sappystick/ARX/docs/figures/SIM_THERMAL.png

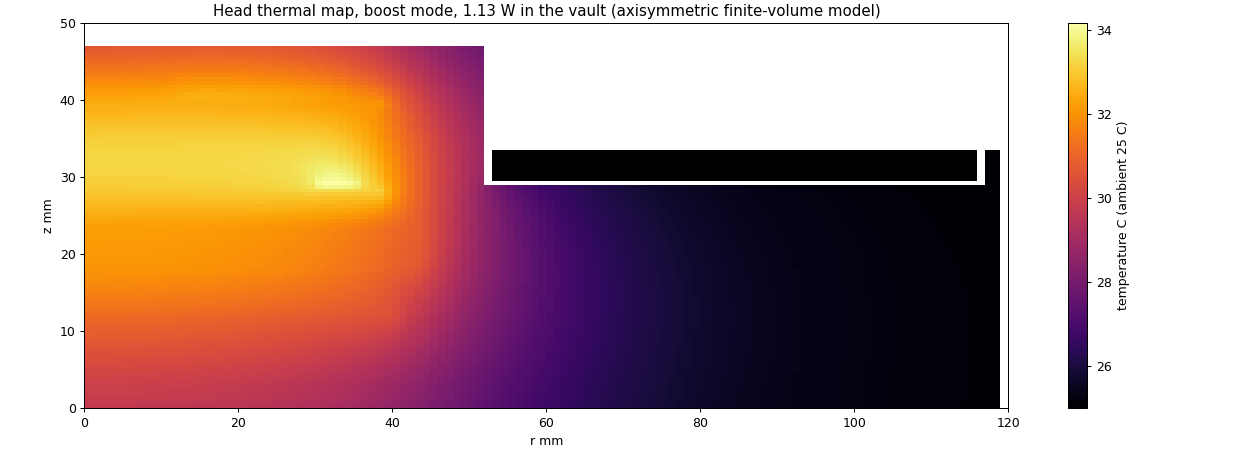
docs/figures/SIM_THERMAL.png
