sappystick/ARX/prompts/cowork/C04_DESIGN_REVIEW_DECK.md

# C04 Design review deck
Use the pptx skill. Build Outputs/DESIGN_REVIEW.pptx (12 slides max) from docs/figures (LEVELS_PLAN_VIEWS, LEVELS_SCHEMATIC, RX_PLATFORM_QUAD, SIM_*, cut-aways) and docs/DESIGN_STATE.md: architecture, coil, vault levels, receiver platform and what the simulation showed (leak 300-1000x lower, first gate 6.3 us), TX stage, thermal, shaft/yoke, corrections log, open items and risks. One decision per slide; every number labelled modeled; last slide: what we need to measure first.
