sappystick/ARX/prompts/P02_CB1D_ROUTING_DRC.md

# P02 Finish CB1D routing and add an independent DRC
STATUS (2026-10-23): done in release 5.1: 46/46 nets, independent DRC 0/0, notch half-width 7.6 mm (not 12 mm). Remaining: KiCad/CAM verification (docs/OPEN_ITEMS.md 2).
Goal: 46/46 nets on CB1D (45/46 now), hatched planes, 12 mm notch at 90 deg, Gerbers, and an INDEPENDENT design-rule check.
Context: src/pcb/pw_design.py (PW=C DISC=1), cb1d_export.py, router.py, route_run.py, gerber_out.py (hatch and notch options exist). The 64-part board has HV nets (coil flyback, damping chain, 630 V coupling cap); data/legacy/.../PF233-CB1D.kicad_dru has the intended rules.
Steps: (1) run `make route-cb1d`, read the failing net, try layer-assignment and ordering changes in router.py (rip-up and reroute, via cost, escape strategy); (2) if still blocked, propose the smallest placement change (move a part, rotate a connector) and re-run placement checks; (3) write tests/drc.py that reads the .net, pads and the route JSON and checks connectivity (every net one component), shorts between nets, minimum clearance by net class (HV >= 1.0 mm), annular ring, drill, notch keep-out, edge clearance; (4) export Gerbers with hatched planes; (5) if KiCad (kicad-cli) is available, import the Gerbers and the .kicad_pcb and run its DRC as a second opinion; (6) update docs and regress.
Acceptance: 46/46 nets, drc.py clean, no solid planes, HV clearance reported. If something cannot be done, say exactly what and why.
