sappystick/ARX/docs/PROCESS.md

# Engineering loop and claims policy
## The loop (every change)
1. State the requirement and the failure it fixes (one sentence, measurable).
2. Change the PARAMETRIC GENERATOR, never an STL by hand.
3. Verify geometry: closed mesh, interface clearances measured from the meshes, fit of real parts (boards, tiles, tubes), print constraints.
4. Verify electronics: ERC/placement/routing/DRC, connector pin-by-pin against neighbouring boards, ratings versus simulated stress.
5. Simulate with stated assumptions; run a sensitivity or convergence check; compare to an analytic limit when one exists.
6. Red-team: ask what would make the result wrong; look for the opposite sign, units, and a frame mix-up.
7. Update docs/DESIGN_STATE.md, CORRECTIONS.md if something earlier was wrong, ASSUMPTIONS.md, OPEN_ITEMS.md, and the regression numbers in tests/regress.py.
8. Package: new versioned files, manifest with hashes, superseded notes.
## Claims policy
- "Modeled" means a simulation with listed assumptions; "built" means printed/wound; "measured" means a bench measurement. Never use a stronger word than the evidence.
- A performance claim needs: the model, the assumptions, the sensitivity, and what measurement would confirm it. "Record" claims are not allowed without comparative measurements.
- If a simulation contradicts an earlier statement, add a row to CORRECTIONS.md and say so plainly in the report.
## Validation ladder
analytic check -> mesh/geometry check -> circuit/field simulation -> independent re-derivation (another method) -> bench test -> field test. Most items here sit at rungs 1-3.
## Definition of done for a part or board
Generator committed; checks pass in tests/regress.py; assumptions listed; superseded files marked; STL/Gerber manifest updated; a figure exists that a reviewer can read in one minute.
