sappystick/ARX/prompts/P09_REGRESSION_RELEASE.md

# P09 Regression and release
Run `make verify-full` and tests/regress.py, extend the regression with every number in docs/DESIGN_STATE.md that can be recomputed, refresh stl/MANIFEST.csv hashes, update docs, commit, and write a release note: what changed, which numbers moved, what is still unproven. Do not push.
