sappystick/ARX/prompts/P10_GITHUB.md

# P10 Publish
Run scripts/push_to_github.sh yourself (it needs your credentials; Claude must not handle tokens). It initialises git, enables Git LFS for STL files and pushes to https://github.com/Sappystick/Arx.git (pass another URL as the first argument). Check that work/ is not committed and that large formers are not in git.
