sappystick/ARX/docs/figures/HEAD_CUTAWAY_B_SPINE.png

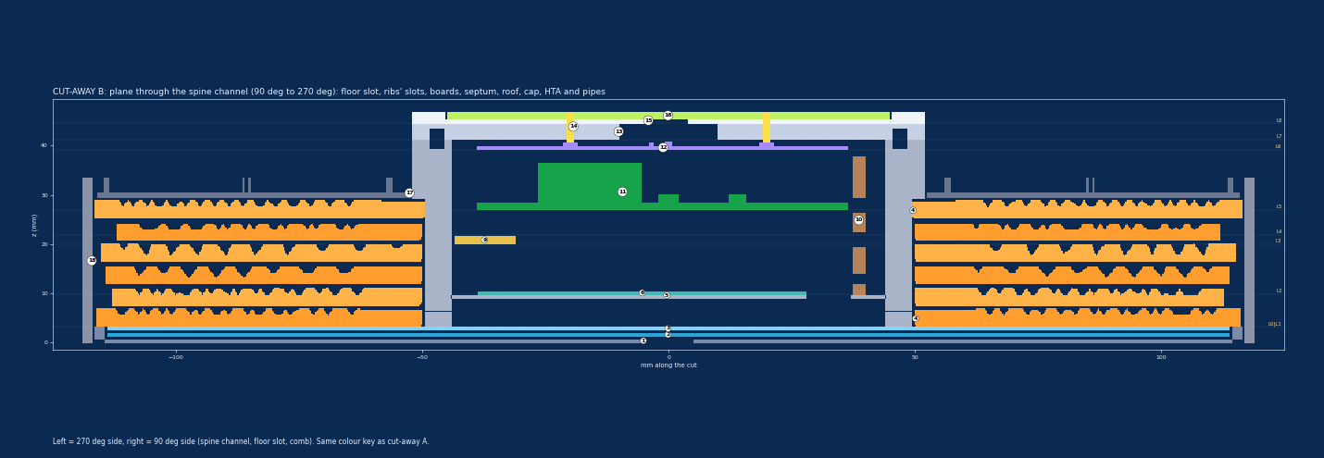
docs/figures/HEAD_CUTAWAY_B_SPINE.png
