sappystick/ARX/docs/figures/HEAD_EXPLODED_LAYERS.png

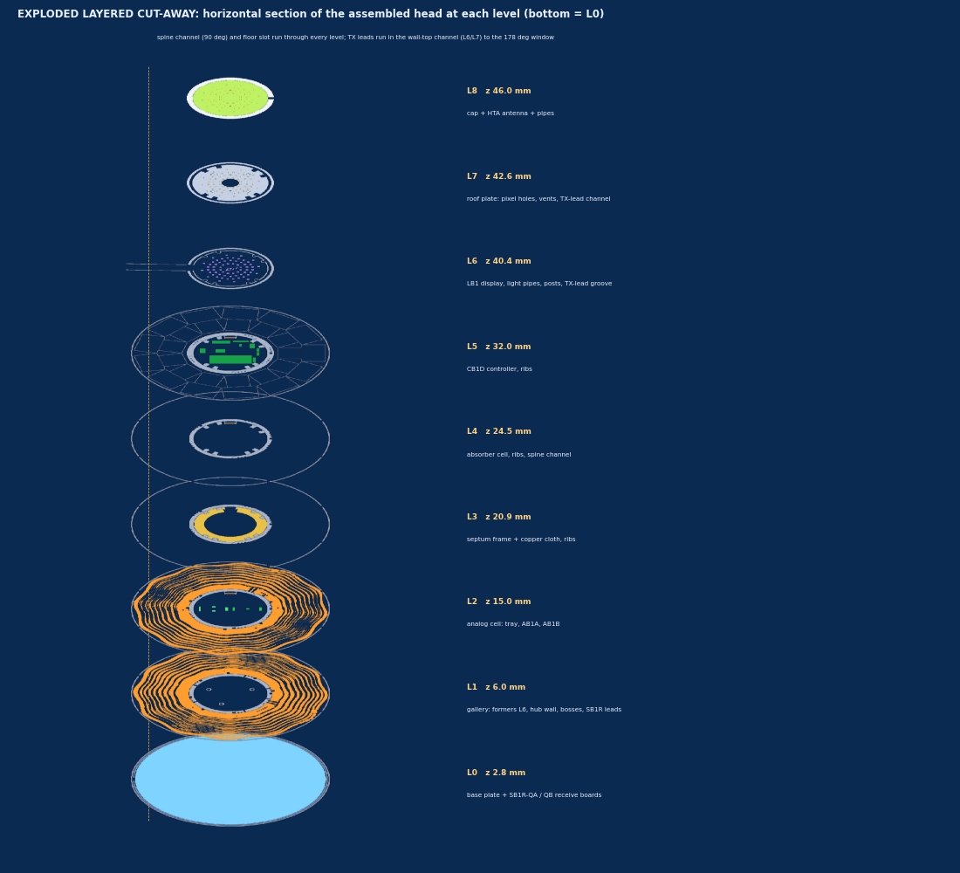
docs/figures/HEAD_EXPLODED_LAYERS.png
