sappystick/ARX/docs/figures/HEAD_LAYERS_EXPLODED.png

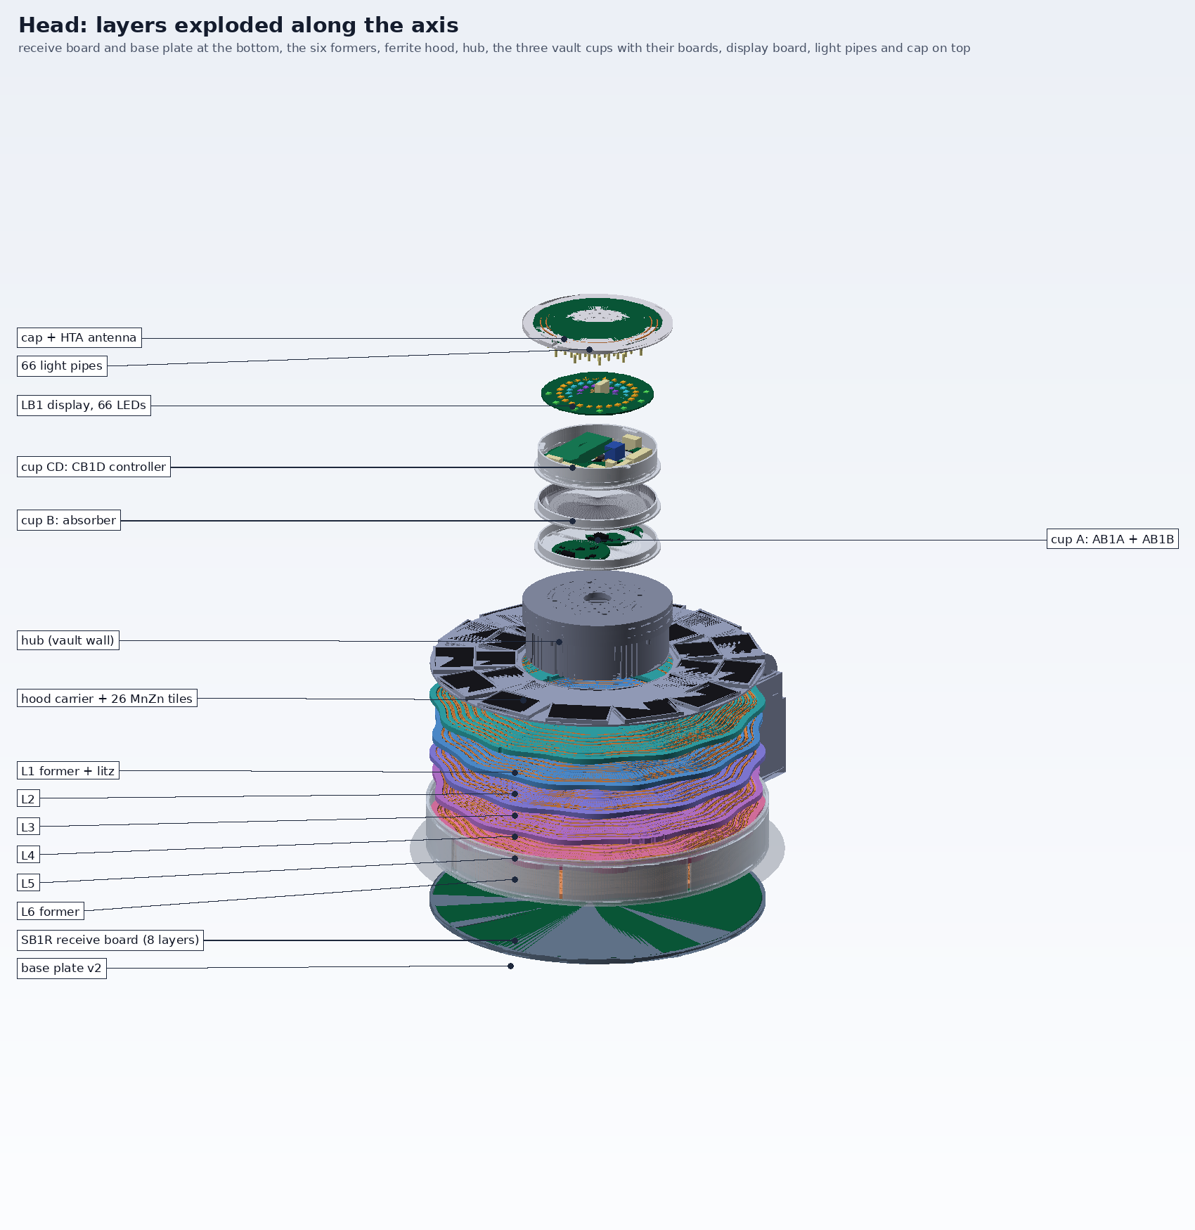
docs/figures/HEAD_LAYERS_EXPLODED.png
