sappystick/ARX/docs/figures/HOOD_V3_LAYOUT.png

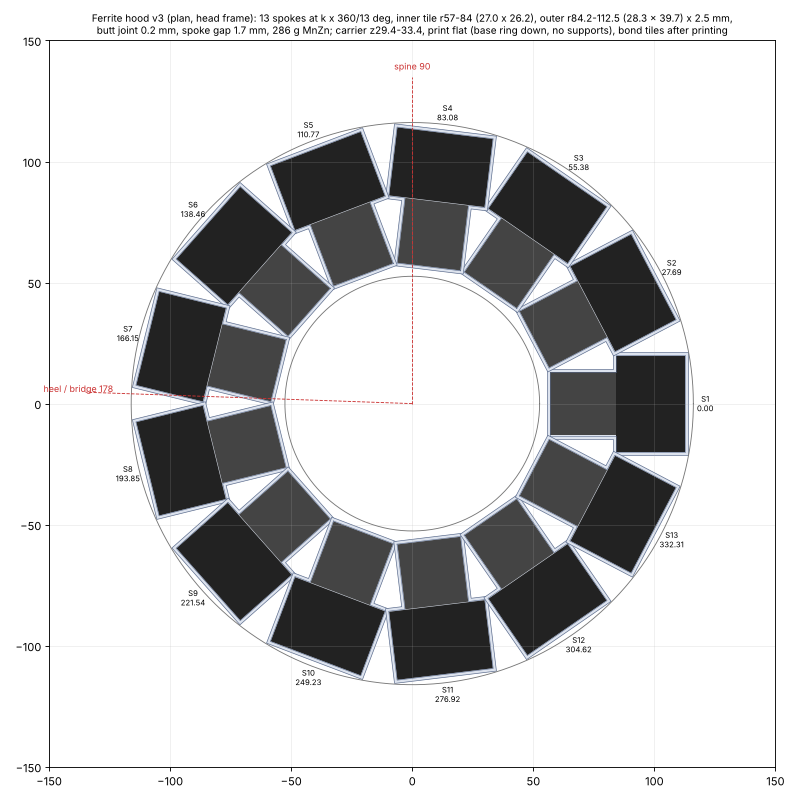
docs/figures/HOOD_V3_LAYOUT.png
