sappystick/ARX/docs/figures/LEVELS_PLAN_VIEWS.png

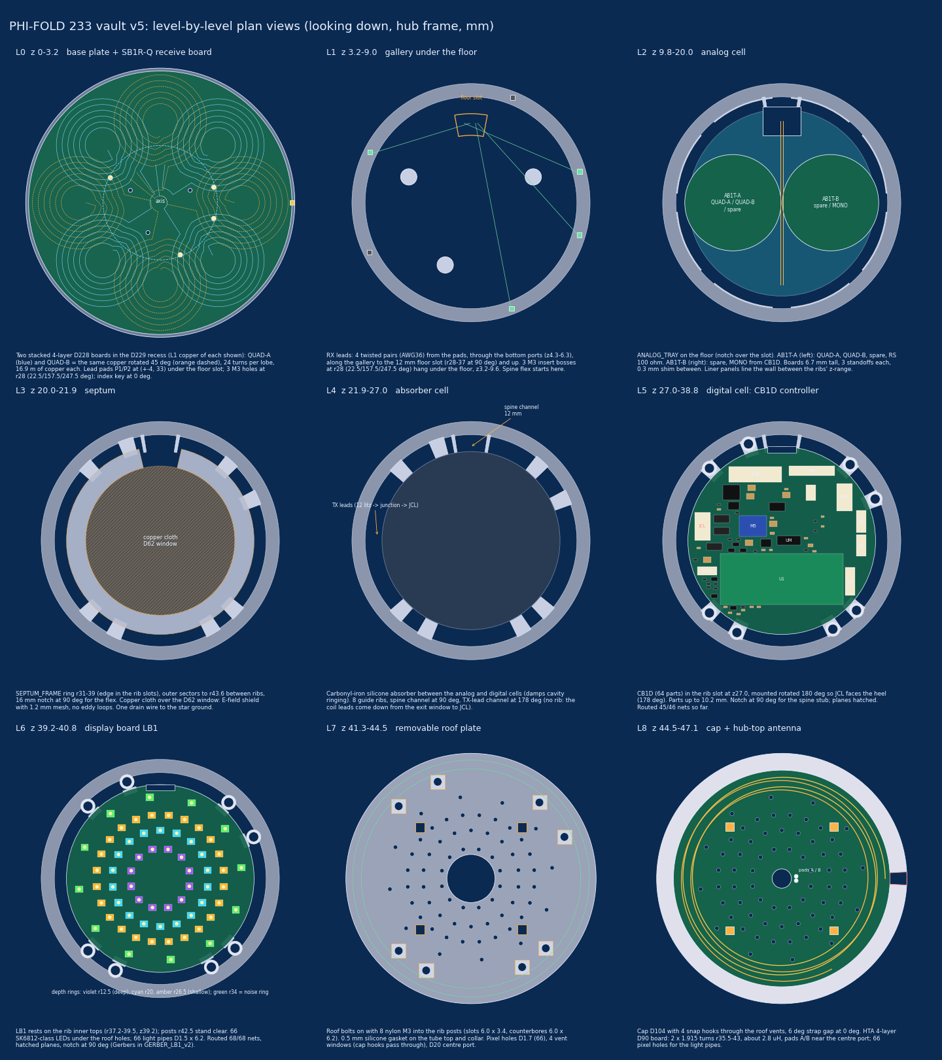
docs/figures/LEVELS_PLAN_VIEWS.png
