sappystick/ARX/docs/figures/LEVELS_SCHEMATIC.png

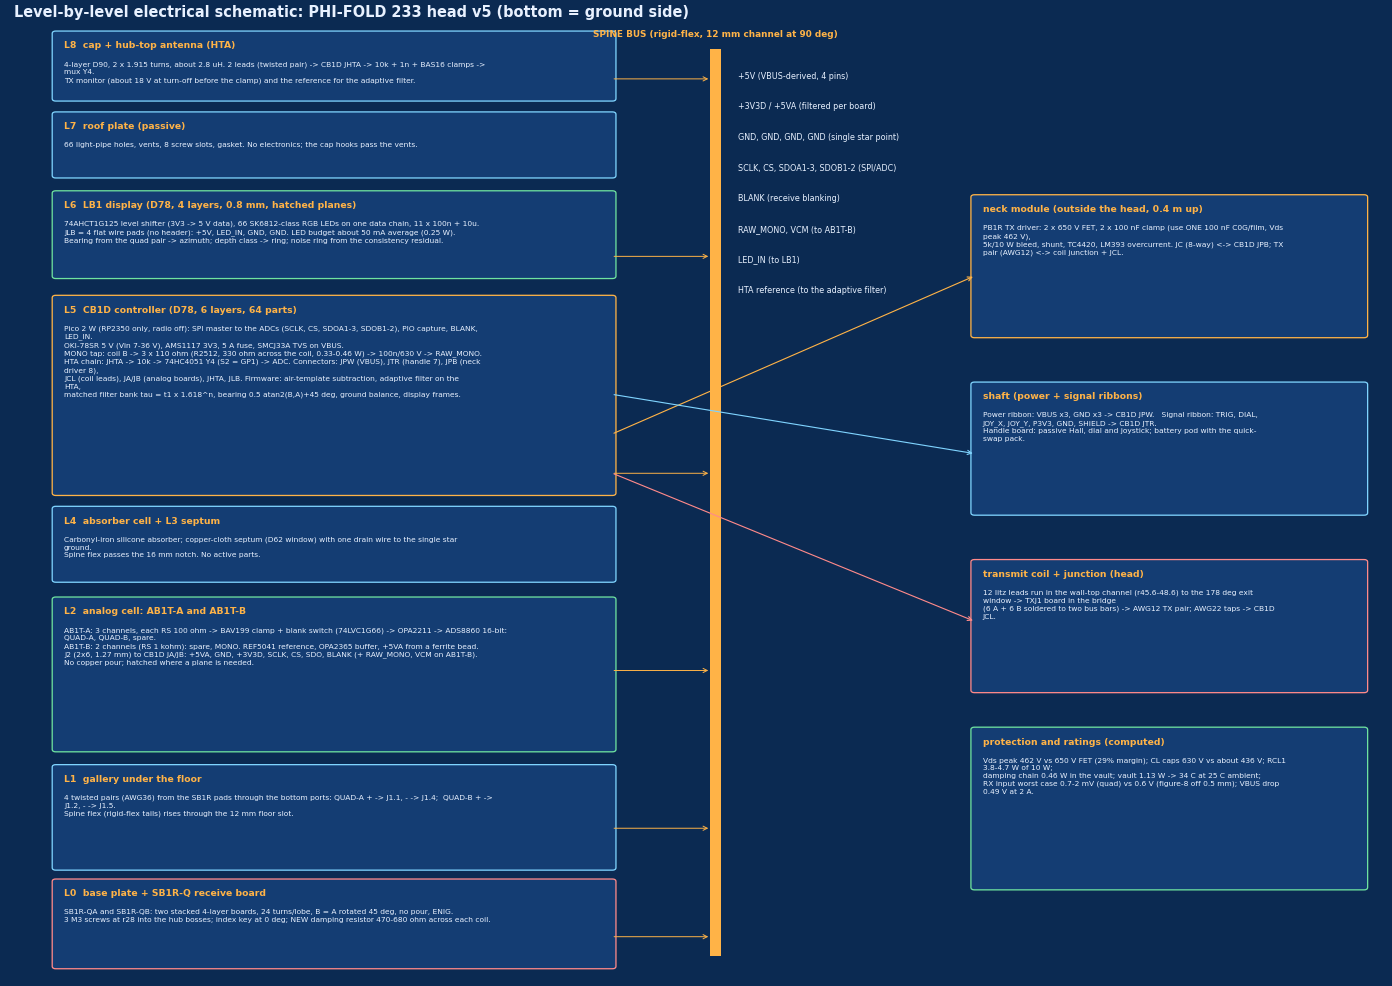
docs/figures/LEVELS_SCHEMATIC.png
