sappystick/ARX/docs/figures/PF233-CB1D_placement_preview.png

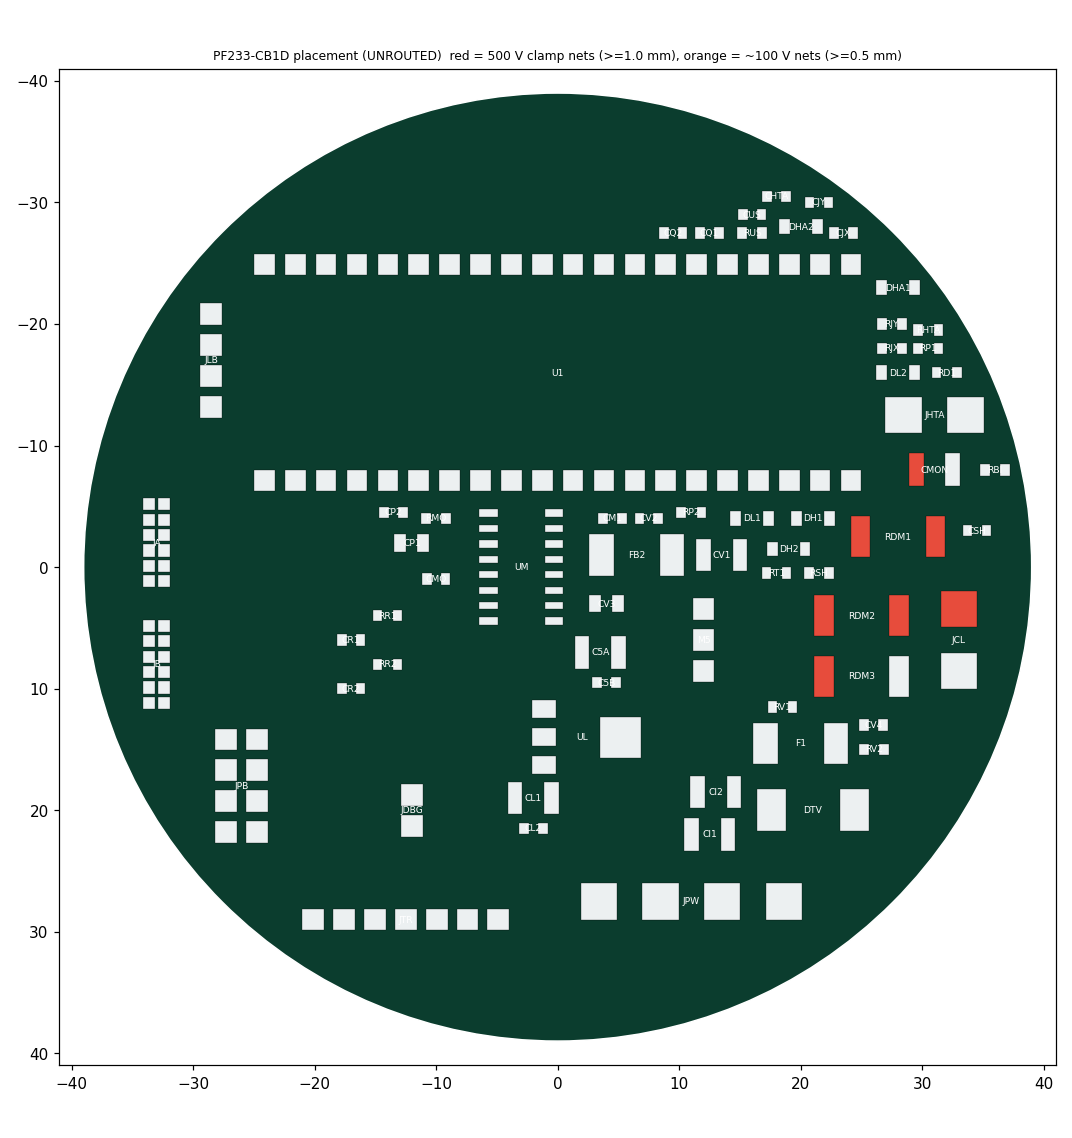
docs/figures/PF233-CB1D_placement_preview.png
