sappystick/ARX/docs/figures/PF233-HTA_preview.png

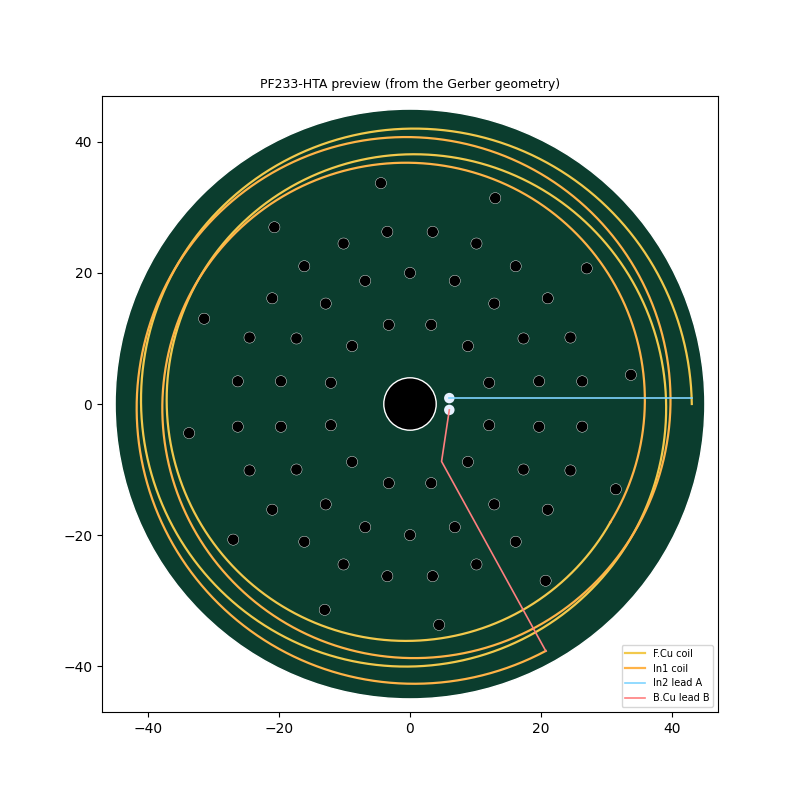
docs/figures/PF233-HTA_preview.png
