sappystick/ARX/docs/figures/RX_PLATFORM_QUAD.png

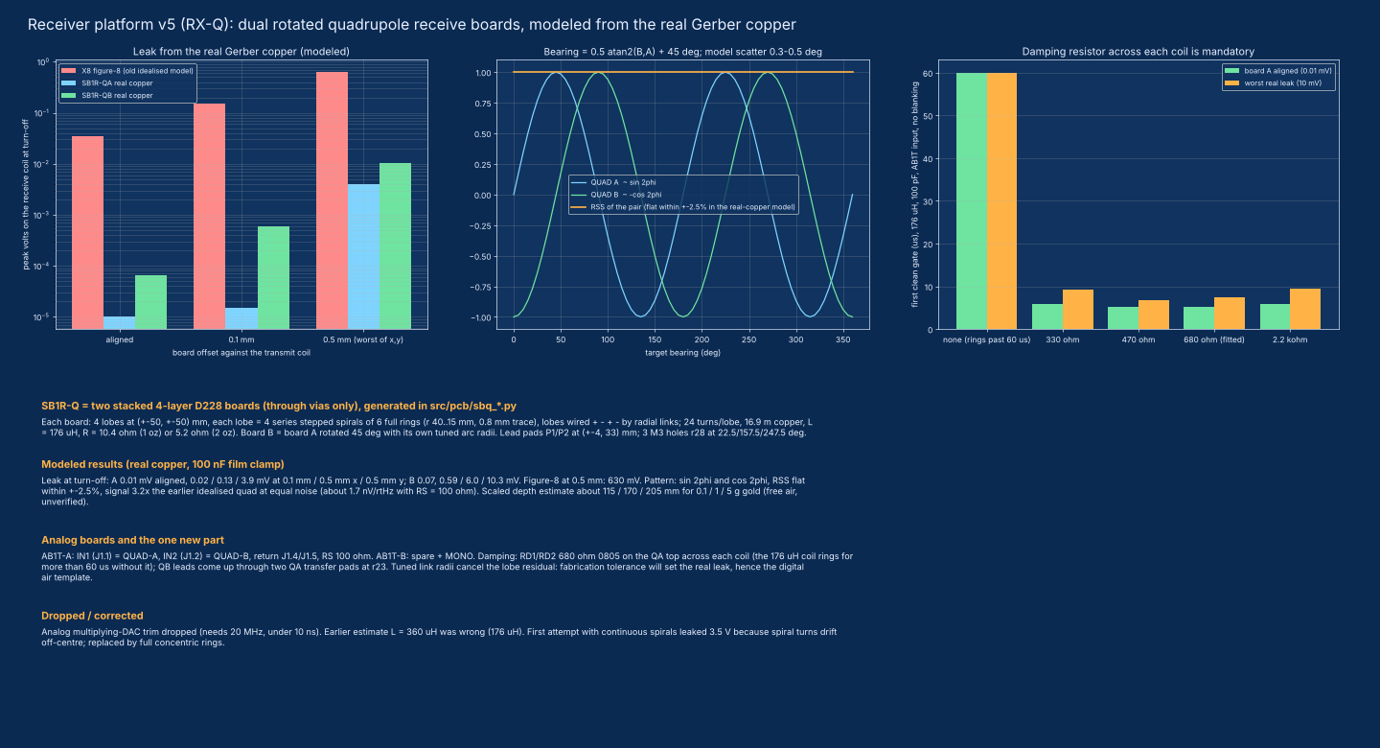
docs/figures/RX_PLATFORM_QUAD.png
