sappystick/ARX/docs/figures/SYSTEM_FOLDED.png

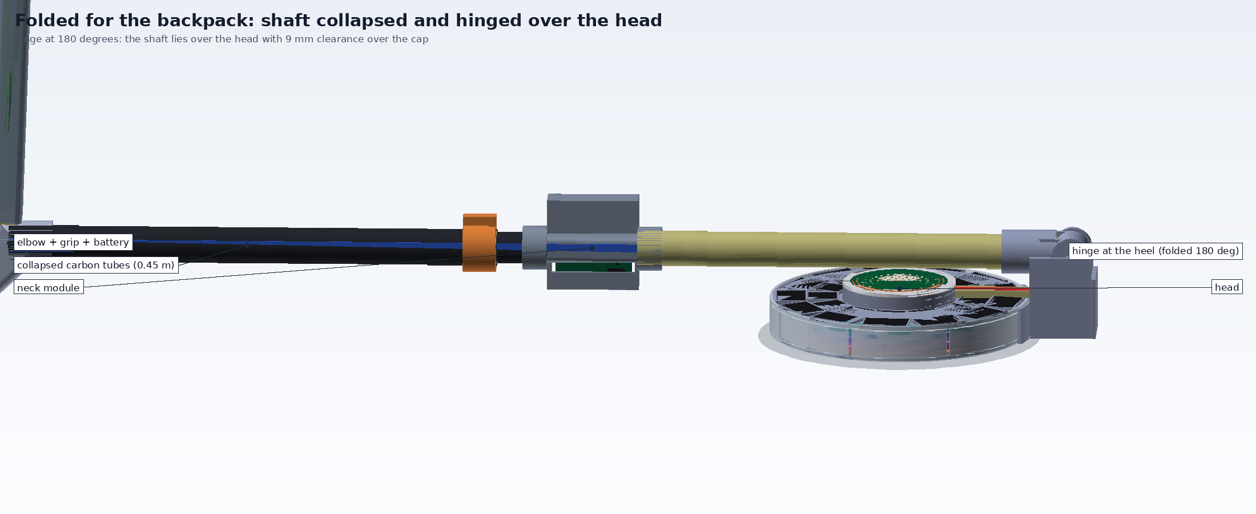
docs/figures/SYSTEM_FOLDED.png
