sappystick/ARX/docs/figures/SYSTEM_SCHEMATIC_v1.png

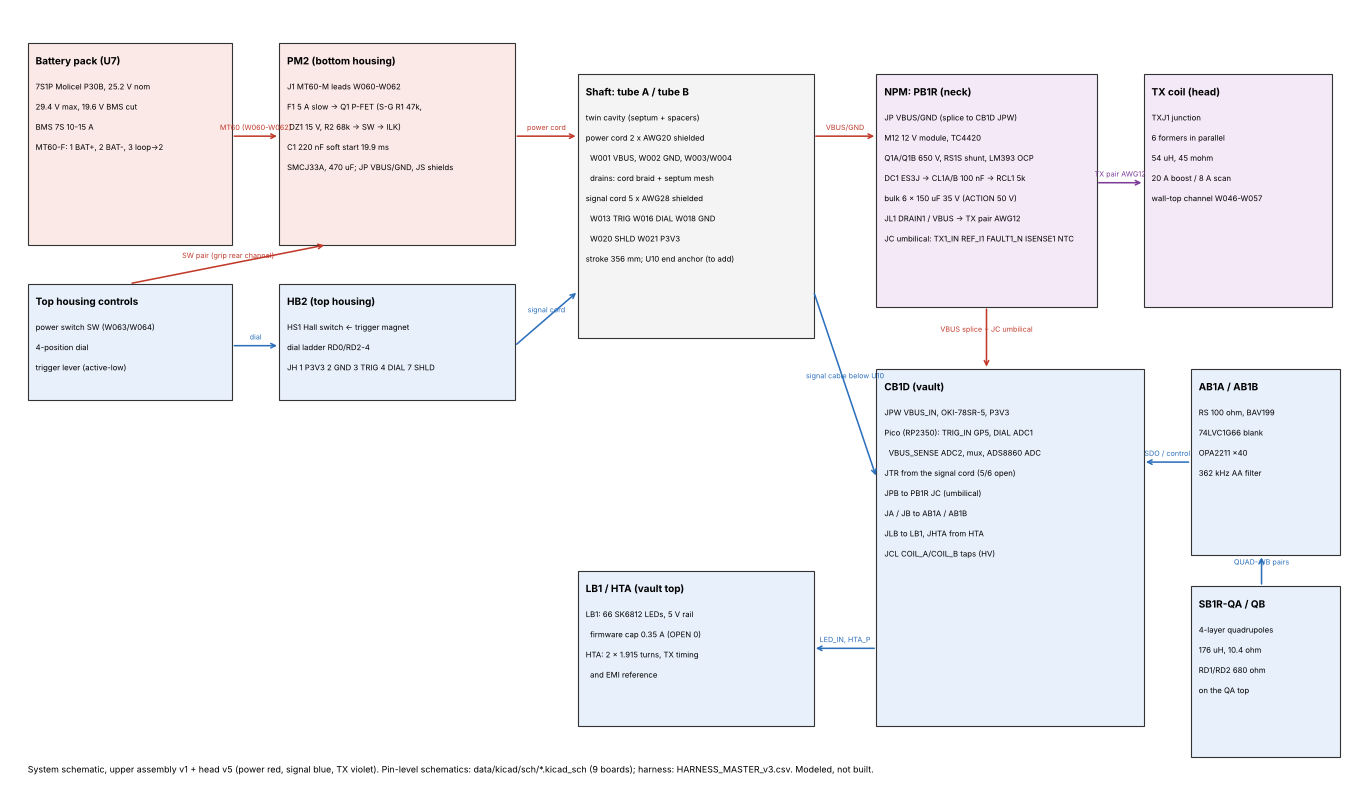
docs/figures/SYSTEM_SCHEMATIC_v1.png
