sappystick/ARX/docs/figures/TARGET_FIELD_LAYERS_3D.png

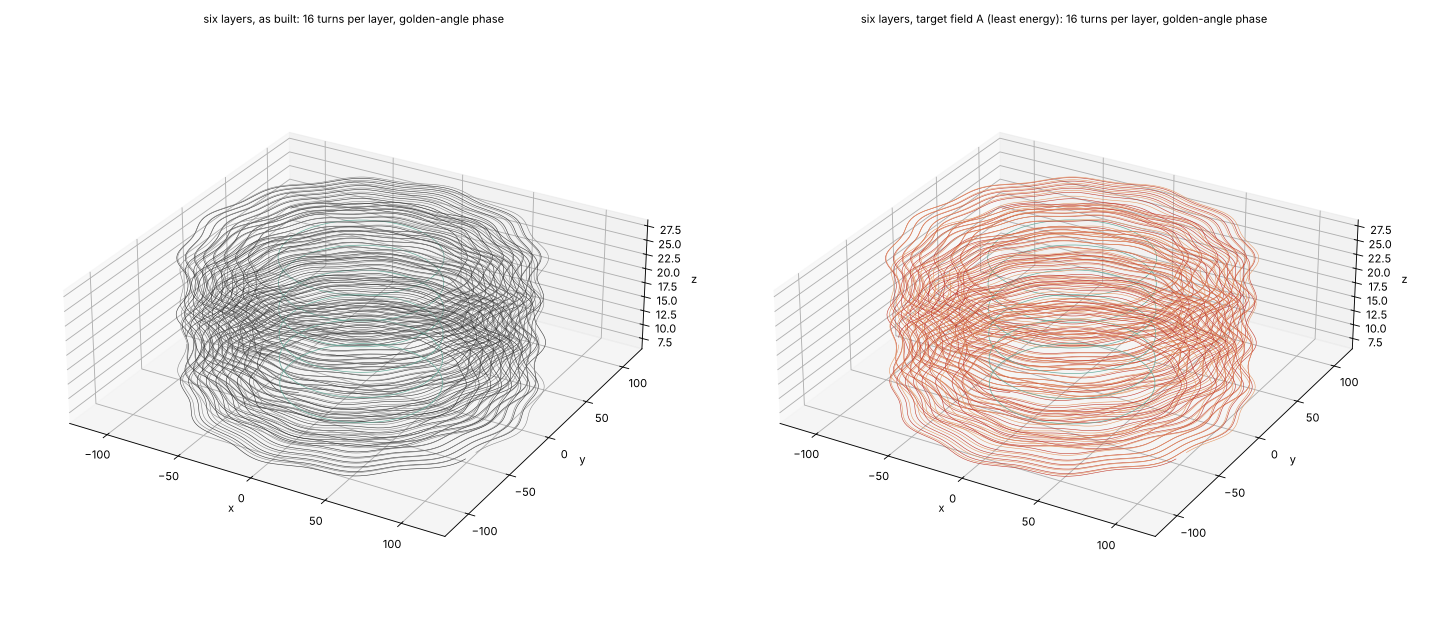
docs/figures/TARGET_FIELD_LAYERS_3D.png
