sappystick/ARX/docs/figures/VAULT2_AND_TANR_DIAGRAM.png

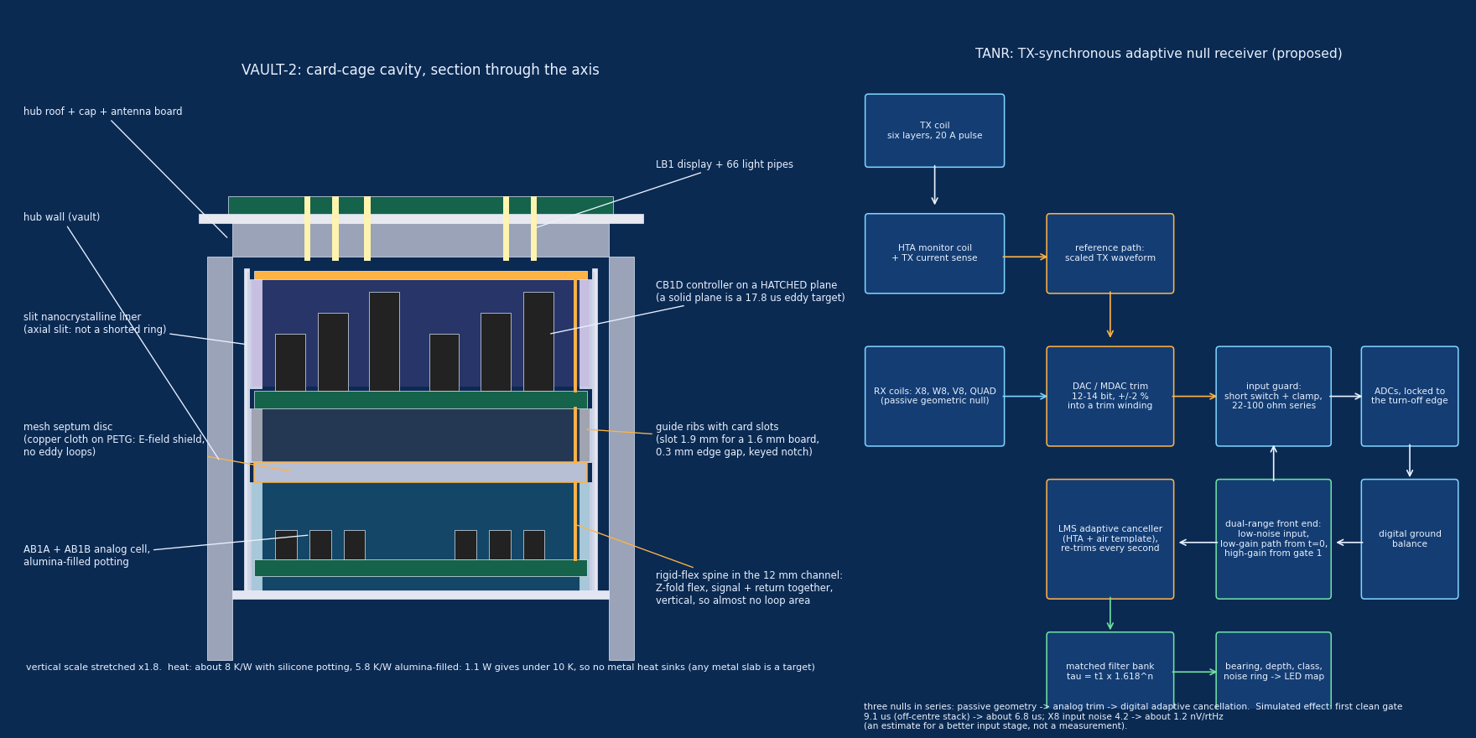
docs/figures/VAULT2_AND_TANR_DIAGRAM.png
