sappystick/ARX/docs/reference/photos/IMG_2941.jpeg

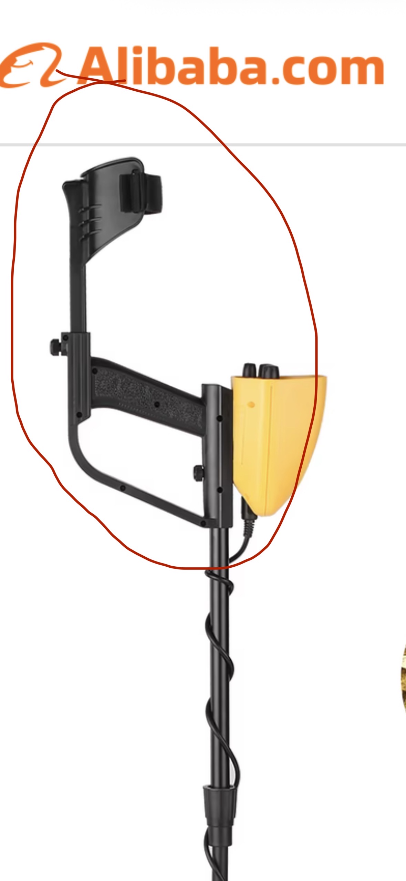
docs/reference/photos/IMG_2941.jpeg
