sappystick/ARX/data/results/LEVEL_NETLIST_FROM_NETLISTS.csv

level | from | pin | net | to | pin | net | status
L2 | CB1D.JA | 1 | +5VA | AB1A.J2 | 1 | +5VA | OK
L2 | CB1D.JA | 2 | GND | AB1A.J2 | 2 | GND | OK
L2 | CB1D.JA | 3 | +3V3D | AB1A.J2 | 3 | +3V3D | OK
L2 | CB1D.JA | 4 | GND | AB1A.J2 | 4 | GND | OK
L2 | CB1D.JA | 5 | SCLK | AB1A.J2 | 5 | SCLK | OK
L2 | CB1D.JA | 6 | CS | AB1A.J2 | 6 | CS | OK
L2 | CB1D.JA | 7 | SDOA1 | AB1A.J2 | 7 | SDO1 | OK
L2 | CB1D.JA | 8 | SDOA2 | AB1A.J2 | 8 | SDO2 | OK
L2 | CB1D.JA | 9 | SDOA3 | AB1A.J2 | 9 | SDO3 | OK
L2 | CB1D.JA | 10 | BLANK | AB1A.J2 | 10 | BLANK | OK
L2 | CB1D.JA | 11 | GND | AB1A.J2 | 11 | GND | OK
L2 | CB1D.JA | 12 | GND | AB1A.J2 | 12 | GND | OK
L2 | CB1D.JB | 1 | +5VA | AB1B.J2 | 1 | +5VA | OK
L2 | CB1D.JB | 2 | GND | AB1B.J2 | 2 | GND | OK
L2 | CB1D.JB | 3 | +3V3D | AB1B.J2 | 3 | +3V3D | OK
L2 | CB1D.JB | 4 | GND | AB1B.J2 | 4 | GND | OK
L2 | CB1D.JB | 5 | SCLK | AB1B.J2 | 5 | SCLK | OK
L2 | CB1D.JB | 6 | CS | AB1B.J2 | 6 | CS | OK
L2 | CB1D.JB | 7 | SDOB1 | AB1B.J2 | 7 | SDO1 | OK
L2 | CB1D.JB | 8 | SDOB2 | AB1B.J2 | 8 | SDO2 | OK
L2 | CB1D.JB | 9 | BLANK | AB1B.J2 | 9 | BLANK | OK
L2 | CB1D.JB | 10 | MONO_IN | AB1B.J2 | 10 | RAW_MONO | OK
L2 | CB1D.JB | 11 | VCM_OUT | AB1B.J2 | 11 | VCM | OK
L2 | CB1D.JB | 12 | GND | AB1B.J2 | 12 | GND | OK
L6 | CB1D.JLB | 1 | +5V | LB1.JLB | 1 | +5V | OK
L6 | CB1D.JLB | 2 | LED_IN | LB1.JLB | 2 | LED_IN | OK
L6 | CB1D.JLB | 3 | GND | LB1.JLB | 3 | GND | OK
L6 | CB1D.JLB | 4 | GND | LB1.JLB | 4 | GND | OK
neck | CB1D.JPB | 1 | UMB_SHLD | PB1R.JC | 1 | UMB_SHLD | OK
neck | CB1D.JPB | 2 | GND | PB1R.JC | 2 | GND | OK
neck | CB1D.JPB | 3 | TX1_IN | PB1R.JC | 3 | TX1_IN | OK
neck | CB1D.JPB | 4 | REF_I1 | PB1R.JC | 4 | REF_I1 | OK
neck | CB1D.JPB | 5 | FAULT1_N | PB1R.JC | 5 | FAULT1_N | OK
neck | CB1D.JPB | 6 | ISENSE1 | PB1R.JC | 6 | ISENSE1 | OK
neck | CB1D.JPB | 7 | NTC_SENSE | PB1R.JC | 7 | NTC_SENSE | OK
neck | CB1D.JPB | 8 | GND | PB1R.JC | 8 | GND | OK
handle | CB1D.JTR | 1 | P3V3 | HB2.JH | 1 | P3V3 | OK
handle | CB1D.JTR | 2 | GND | HB2.JH | 2 | GND | OK
handle | CB1D.JTR | 3 | TRIG_EXT | HB2.JH | 3 | TRIG | OK
handle | CB1D.JTR | 4 | DIAL_EXT | HB2.JH | 4 | DIAL | OK
handle | CB1D.JTR | 5 | JOY_X | HB2.JH | 5 | JH5_NC | OK
handle | CB1D.JTR | 6 | JOY_Y | HB2.JH | 6 | JH6_NC | OK
handle | CB1D.JTR | 7 | SHIELD | HB2.JH | 7 | SHIELD | OK
power | CB1D.JPW | 1 | VBUS_IN | PB1R.JP | 1 | VBUS | OK
power | CB1D.JPW | 2 | VBUS_IN | PB1R.JP | 2 | VBUS | OK
power | CB1D.JPW | 3 | GND | PB1R.JP | 3 | GND | OK
power | CB1D.JPW | 4 | GND | PB1R.JP | 4 | GND | OK
power | CB1D.JPW | 1 | VBUS_IN | PM2.JP | 1 | VBUS | OK
power | CB1D.JPW | 2 | VBUS_IN | PM2.JP | 2 | VBUS | OK
power | CB1D.JPW | 3 | GND | PM2.JP | 3 | GND | OK
power | CB1D.JPW | 4 | GND | PM2.JP | 4 | GND | OK
TX | CB1D.JCL | 1 | COIL_B | PB1R.JL1 | 1 | DRAIN1 | OK
TX | CB1D.JCL | 2 | COIL_A | PB1R.JL1 | 2 | VBUS | OK
