sappystick/ARX/data/results/SYSTEM_STRESS_MARGINS.csv

part | stress | value | rating | unit | margin_pct | required_margin_pct | status | note
IPB65R095C7 (2 in parallel) | Vds peak, design case (one 100 nF C0G/film) | 462.368 | 650 | V | 28.9 | 20 | PASS | drain peak at turn-off; X7R as built is lower (379 V) but loses capacitance with bias
IPB65R095C7 | Vds peak, as-built 2 x X7R derated | 379.452 | 650 | V | 41.6 | 20 | PASS
IPB65R095C7 | drain current per FET at 20 A peak | 10.0 | 24 | A | 58.3 | 30 | PASS | continuous rating at 25 C used as a conservative pulse reference (datasheet check needed)
ES3J clamp diode | reverse voltage (capacitor peak) | 435.163 | 600 | V | 27.5 | 20 | PASS
ES3J clamp diode | repetitive peak current | 19.877 | 100 | A | 80.1 | 50 | PASS | datasheet IFSM is non-repetitive 8.3 ms: repetitive 4 us pulses at 400 Hz must be confirmed
CL1A/B clamp capacitor 630 V | voltage | 435.163 | 630 | V | 30.9 | 20 | PASS | C0G/film only; X7R loses 65 percent of capacitance at this bias
RCL1 5 kohm 10 W | power | 3.815 | 10 | W | 61.9 | 30 | PASS | x7r case 4.7 W
3 x 110 ohm R2512 chain | voltage per resistor at flyback peak | 145.456 | 200 | V | 27.3 | 20 | PASS | assumed 200 V working voltage for R2512
3 x 110 ohm R2512 chain | power per resistor | 0.153 | 1.0 | W | 84.7 | 50 | PASS
MONO coupling cap 100 nF / 630 V | voltage | 436.368 | 630 | V | 30.7 | 20 | PASS
BAV199 input clamp (MONO path) | peak clamp current through RS 1 kohm | 0.431 | 4.0 | A | 89.2 | 50 | PASS | 1 us surge rating assumed 4 A; average power negligible
TXJ1 bus A to B | creepage gap for 460 V peak | 460 | 552.0 | V | 16.7 | 0 | PASS | 3.0 mm edge gap vs about 2.5 mm needed (IEC 60664-1 style estimate, pollution 2); plus 1.6 mm FR4 between layers
TX pair AWG12 600 V | voltage | 436.368 | 600 | V | 27.3 | 20 | PASS
SMCJ33A TVS | VBUS maximum (7S full charge 29.4 V) | 29.4 | 33 | V | 10.9 | 5 | PASS | standoff voltage
OKI-78SR-5 module | input voltage maximum | 29.4 | 36 | V | 18.3 | 20 | WATCH
TX coil litz | rms current at 20 A / 400 Hz (Ipk sqrt(D/3)) | 1.488 | 3.0 | A | 50.4 | 30 | PASS | about 3 A rms for 1.2 mm litz is conservative
Vault | worst-case hot spot (boost + 0.5 W LEDs, 25 C ambient) | 35.6 | 80 | C | 55.5 | 30 | PASS | PETG Tg about 80 C; FR4 85 C
Vault | hot spot at 40 C ambient | 50.6 | 80 | C | 36.8 | 30 | PASS
PB1R bulk capacitors 6 x 150 uF | voltage droop per pulse (charge 415 uC) | 0.461 | 1.3 | V | 64.5 | 0 | PASS | 5 percent of VBUS allowed
Power cord AWG20 pair (upper v1) | average current in boost (7.7 W / 25.2 V / 0.85) | 0.359 | 5.0 | A | 92.8 | 50 | PASS | coiled cord in the shaft power cavity; 5 A continuous assumed for enclosed AWG20 silicone (ASSUMPTIONS 27); replaces the AWG28 x 3 ribbon
PM2 fuse F1 5 A slow | pulse-recharge peak of the PB1R bulk through the cord (power_dock_check.py) | 3.788 | 5.0 | A | 24.2 | 20 | PASS | slow-blow: carries the rated current continuously; peaks last about a millisecond
Battery pack 7S1P Molicel P30B | average current in boost | 0.359 | 30.0 | A | 98.8 | 50 | PASS | 30 A continuous (datasheet value, unverified here)
LED rail (OKI-78SR 1.5 A) | 66 LEDs at full white 60 mA each | 3.96 | 1.5 | A | -164.0 | 0 | FAIL | FAILS unless the firmware caps the LED current: REQUIREMENT firmware limit 0.35 A total (about 1.75 W)
LED rail with the firmware cap | capped LED current + Pico + ADC (0.35 + 0.15) | 0.5 | 1.5 | A | 66.7 | 30 | PASS | requires the firmware cap
TX lead channel | litz fill ratio | 0.58 | 0.7 | ratio | 17.1 | 15 | PASS | wall-top groove + roof channel
TX layers | DC current sharing deviation | 0.014 | 0.05 | fraction | 71.2 | 50 | PASS | lead length differences
TC4420 gate driver (2 FETs) | gate charge per turn-off (2 x 45 nC, UNVERIFIED) at 12 V: peak current with 2.2 ohm gate resistors | 3.75 | 6.0 | A | 37.5 | 30 | PASS | turn-off in about 20 ns, negligible against the 3.8 us flyback; datasheet Qg and RG values must be confirmed
TC4420 gate driver | average drive power 90 nC x 12 V x 400 Hz | 0.432 | 200 | mW | 99.8 | 50 | PASS
