sappystick/ARX/data/results/hood_v3_tile_cut_sheet.dxf

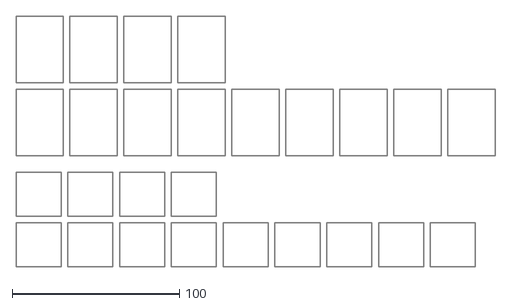
[picture p16: CAD file, 2026-10-23]
data/results/hood_v3_tile_cut_sheet.dxf
286.7 x 149.8
