sappystick/ARX/stl/head/LOTUS_HOOD_CARRIER_v3_butted.stl

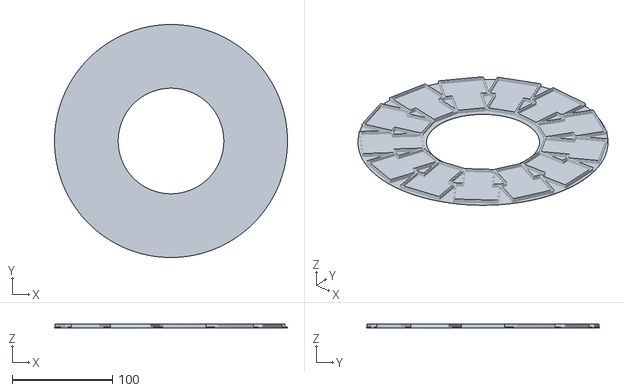
[picture p17: CAD file, 2026-10-23]
stl/head/LOTUS_HOOD_CARRIER_v3_butted.stl
232.2 x 232.2 x 4.00
