sappystick/ARX/stl/pins/PIN_interface1_n4_190.0deg.stl

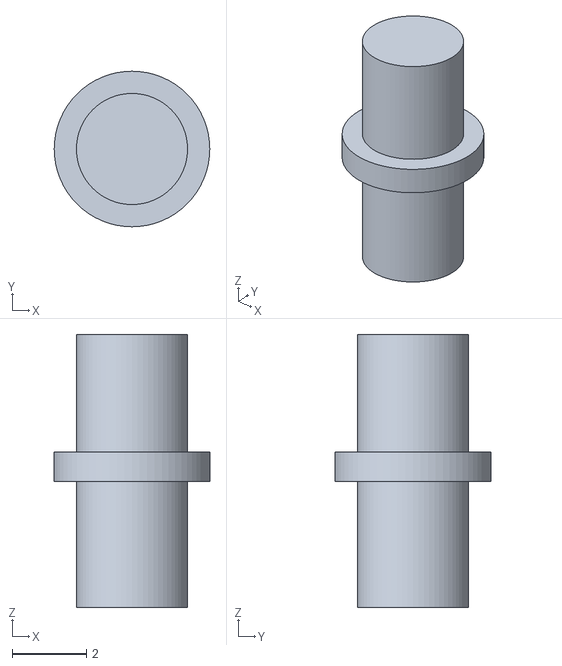
[picture p18: CAD file, 2026-10-23]
stl/pins/PIN_interface1_n4_190.0deg.stl
4.20 x 4.20 x 7.37
