sappystick/ARX/stl/shaft_handle/BAT_B3_contact_plate.stl

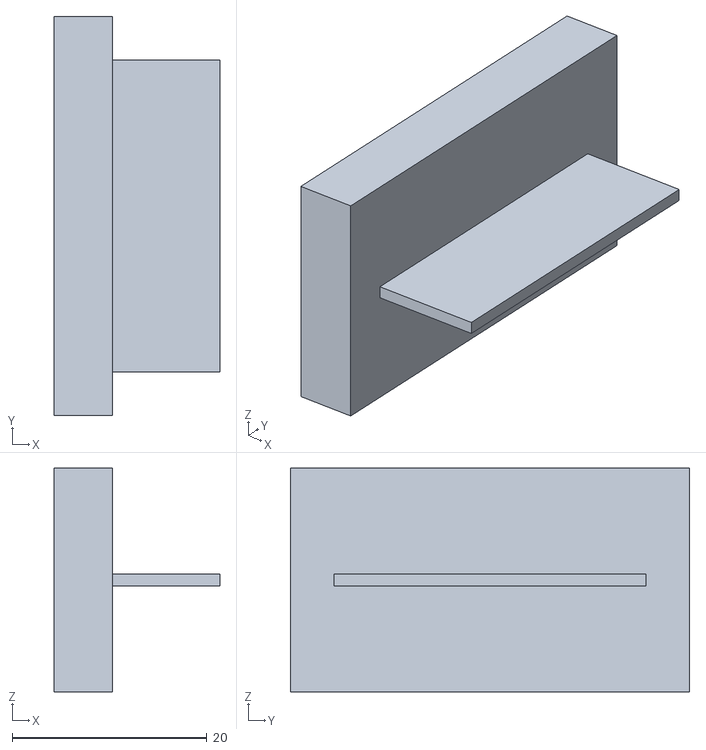
[picture p19: CAD file, 2026-10-23]
stl/shaft_handle/BAT_B3_contact_plate.stl
17.0 x 41.0 x 23.0
