sappystick/ARX/stl/upper/U6_BATTERY_DOCK.stl

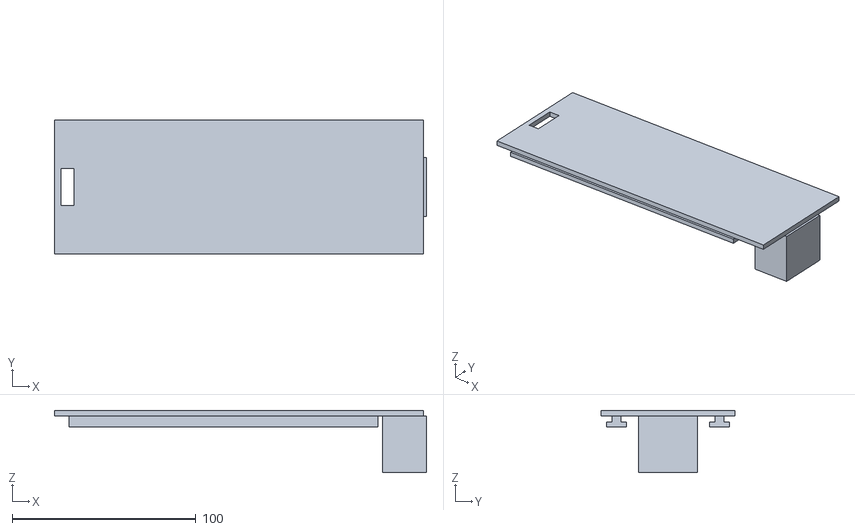
[picture p20: CAD file, 2026-10-23]
stl/upper/U6_BATTERY_DOCK.stl
202.5 x 73.0 x 33.8
