sappystick/ARX/stl/yoke/UMBILICAL_BRIDGE.stl

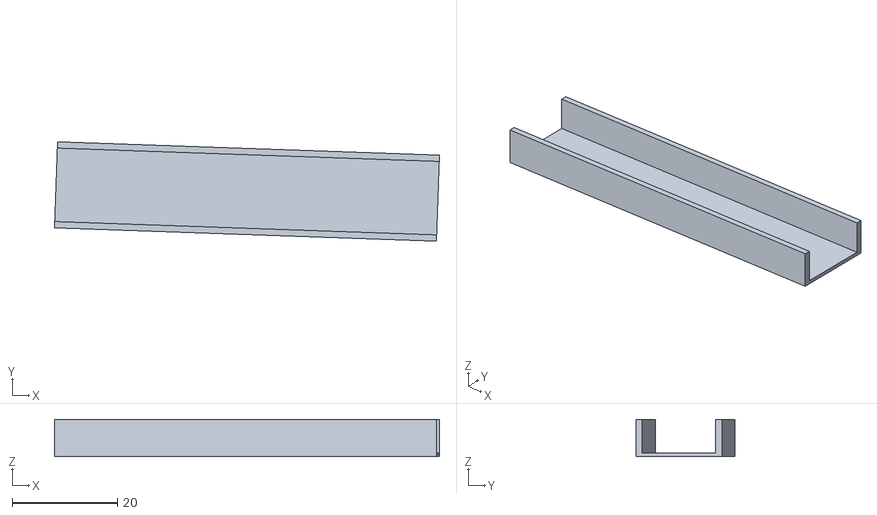
[picture p21: CAD file, 2026-10-23]
stl/yoke/UMBILICAL_BRIDGE.stl
73.3 x 18.9 x 7.10
