sappystick/ARX/data/results/shield_and_gasket_templates.dxf

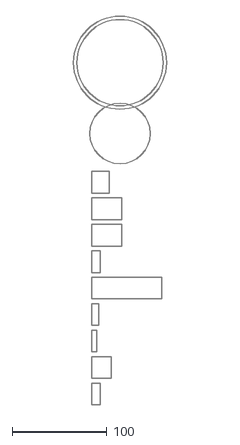
[picture p22: CAD file, 2026-10-23]
data/results/shield_and_gasket_templates.dxf
98.4 x 411.2
