sappystick/ARX/stl/head/HUB_CAP_HTA_v3_vault.stl

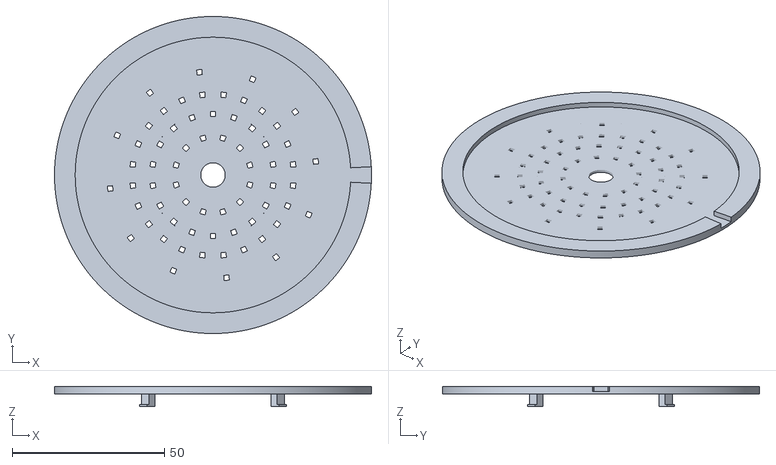
[picture p23: CAD file, 2026-10-23]
stl/head/HUB_CAP_HTA_v3_vault.stl
104.0 x 104.0 x 6.70
