sappystick/ARX/stl/pins/PIN_interface4_n16_40.1deg.stl

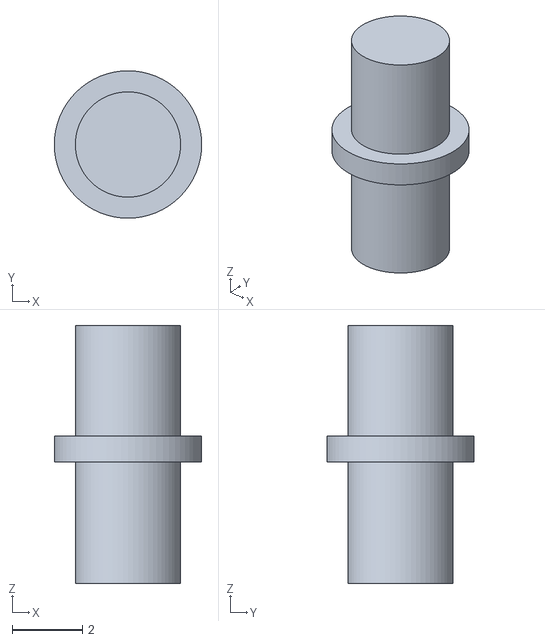
[picture p24: CAD file, 2026-10-23]
stl/pins/PIN_interface4_n16_40.1deg.stl
4.20 x 4.20 x 7.35
