sappystick/ARX/stl/shaft_handle/ELB_E2_grip_endcap.stl

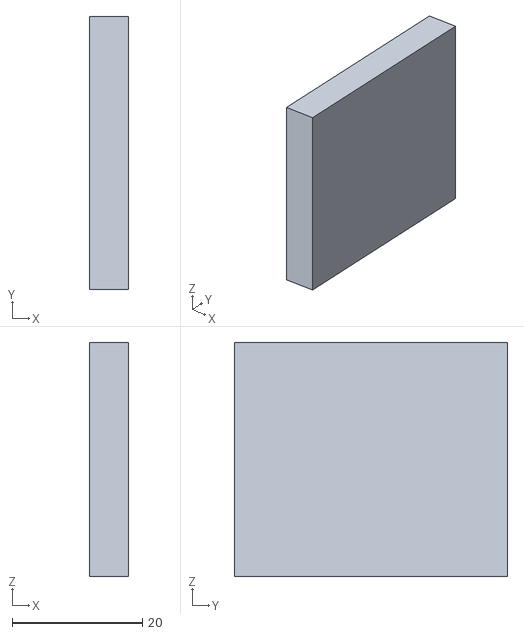
[picture p25: CAD file, 2026-10-23]
stl/shaft_handle/ELB_E2_grip_endcap.stl
6.00 x 42.0 x 36.0
