sappystick/ARX/stl/yoke/BUSHING_IN_TUBE_A.stl

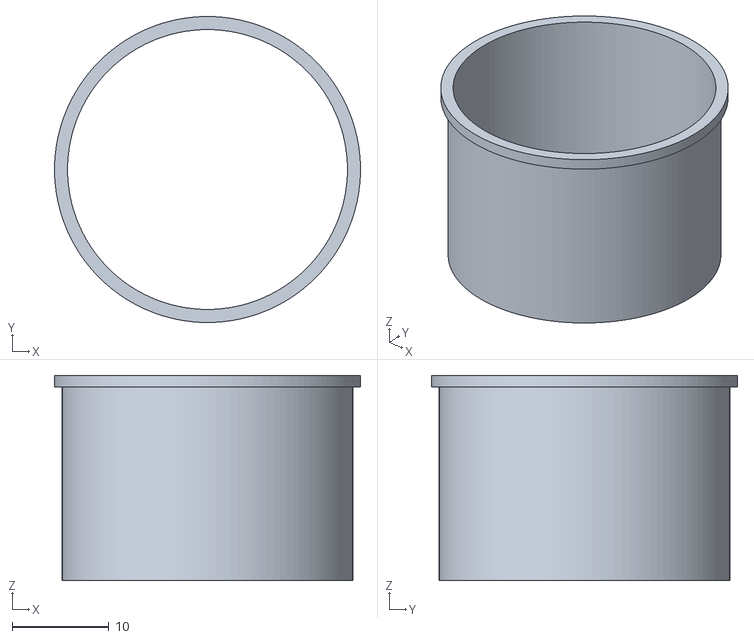
[picture p26: CAD file, 2026-10-23]
stl/yoke/BUSHING_IN_TUBE_A.stl
31.6 x 31.6 x 21.2
