sappystick/ARX/data/results/liner_patterns.dxf

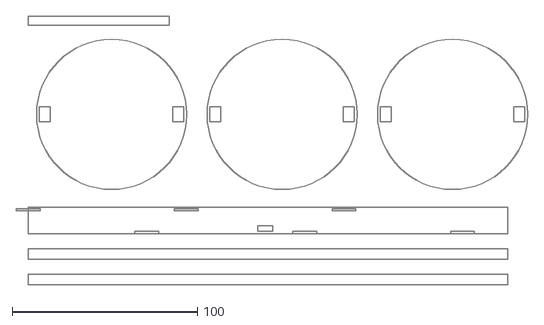
[picture p27: CAD file, 2026-10-23]
data/results/liner_patterns.dxf
275.9 x 145.0
