sappystick/ARX/stl/head/TXJ1_CRADLE_v1.stl

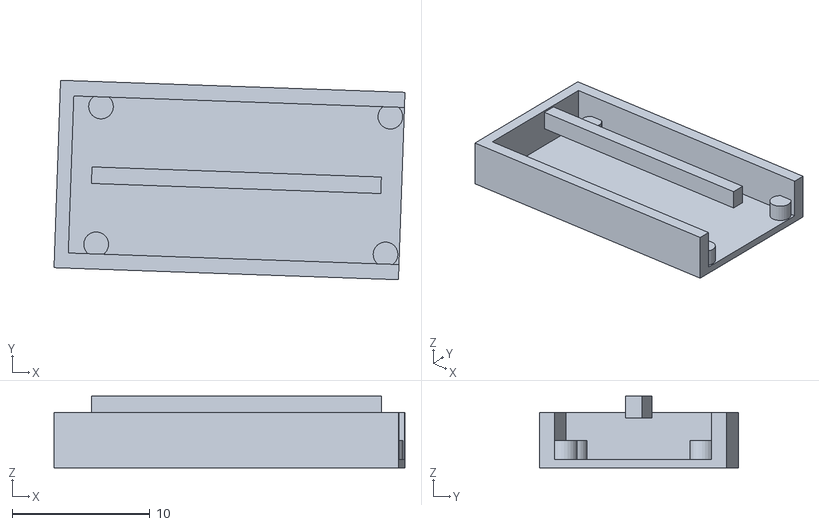
[picture p28: CAD file, 2026-10-23]
stl/head/TXJ1_CRADLE_v1.stl
25.5 x 14.5 x 5.20
