sappystick/ARX/stl/pins/PIN_interface2_n6_105.0deg.stl

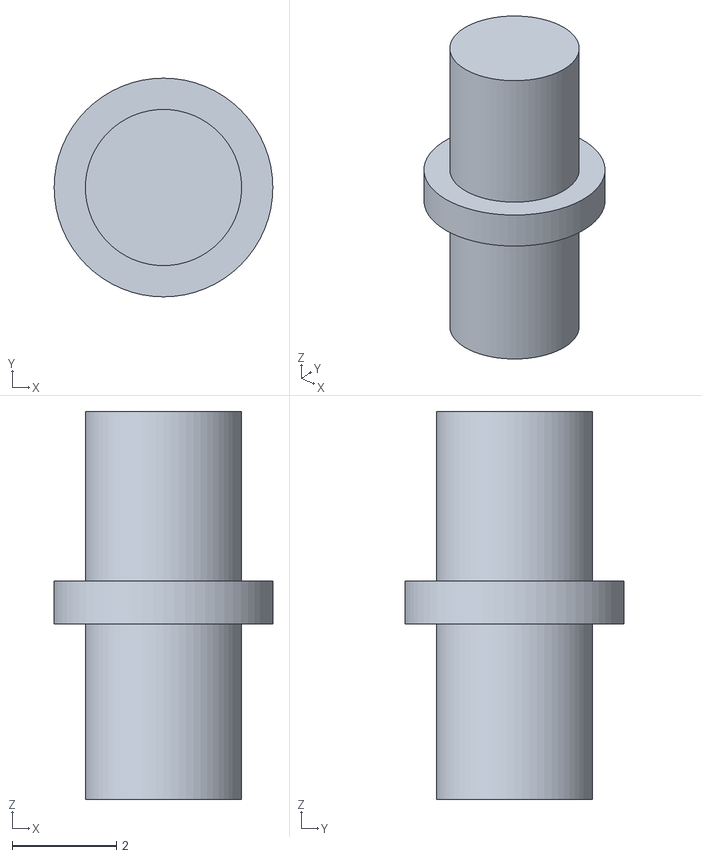
[picture p29: CAD file, 2026-10-23]
stl/pins/PIN_interface2_n6_105.0deg.stl
4.20 x 4.20 x 7.45
