sappystick/ARX/stl/shaft_handle/NPM_N2_lid_with_fill_ports.stl

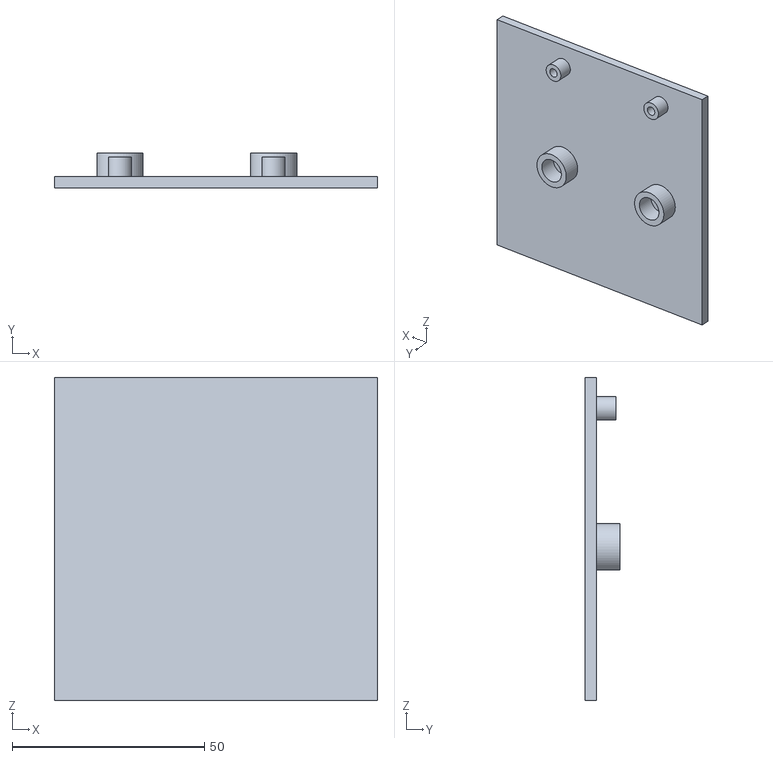
[picture p30: CAD file, 2026-10-23]
stl/shaft_handle/NPM_N2_lid_with_fill_ports.stl
84.0 x 9.00 x 84.0
