sappystick/ARX/stl/head/SPINE_COMB_v5.stl

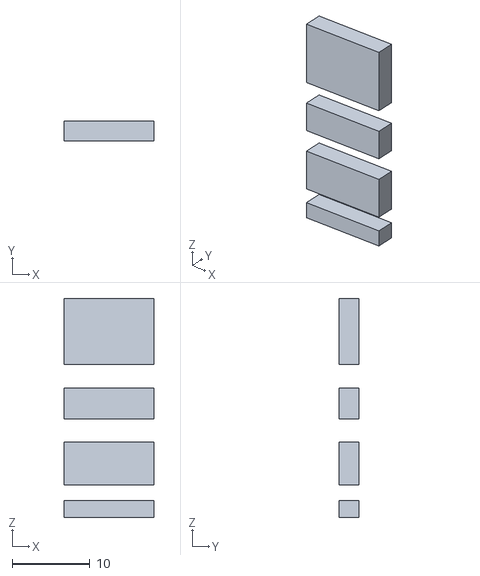
[picture p31: CAD file, 2026-10-23]
stl/head/SPINE_COMB_v5.stl
11.6 x 2.60 x 28.2
