sappystick/ARX/stl/shaft_handle/NPM_N1_body_with_tunnel.stl

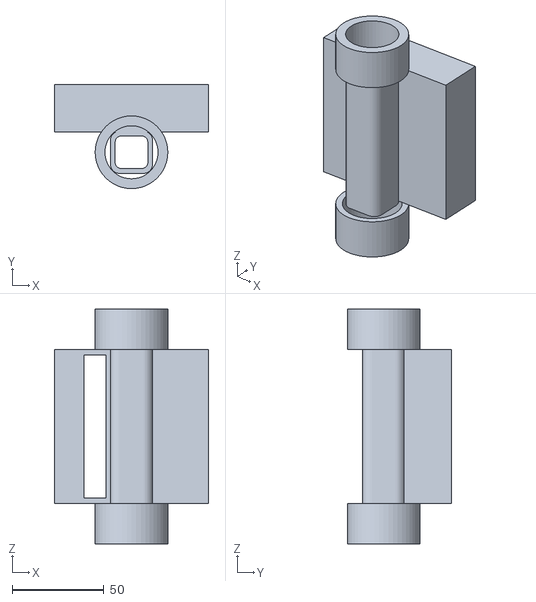
[picture p32: CAD file, 2026-10-23]
stl/shaft_handle/NPM_N1_body_with_tunnel.stl
84.0 x 56.8 x 128.0
