sappystick/ARX/stl/head/SEPTUM_FRAME_v5.stl

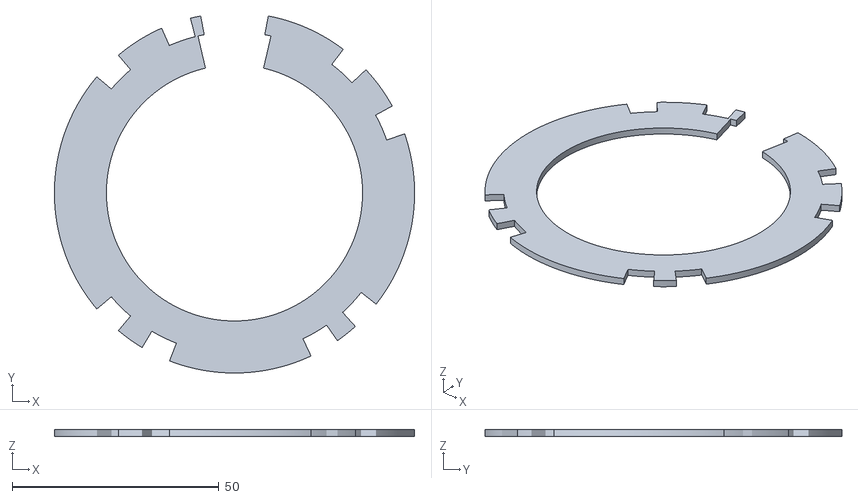
[picture p33: CAD file, 2026-10-23]
stl/head/SEPTUM_FRAME_v5.stl
87.2 x 86.4 x 1.70
