sappystick/ARX/stl/shaft_handle/CAS_R2_trolley.stl

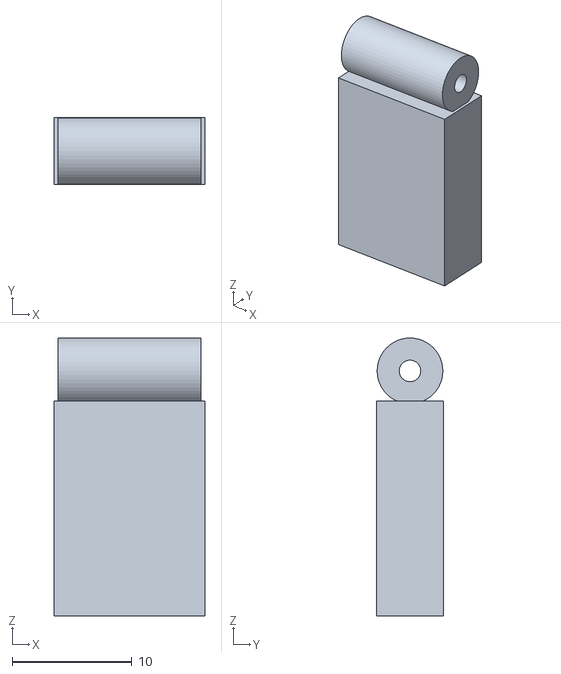
[picture p34: CAD file, 2026-10-23]
stl/shaft_handle/CAS_R2_trolley.stl
12.6 x 5.60 x 23.2
