sappystick/ARX/stl/head/FERRITE_TILE_OUTER_v2_reference.stl

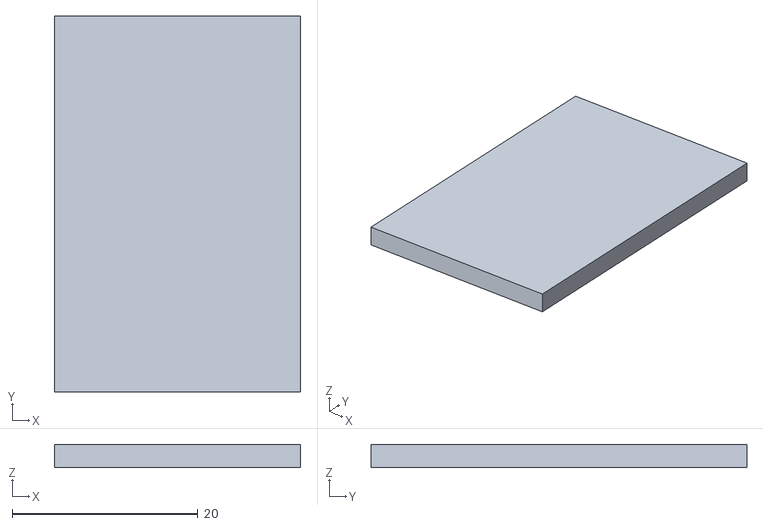
[picture p35: CAD file, 2026-10-23]
stl/head/FERRITE_TILE_OUTER_v2_reference.stl
26.5 x 40.5 x 2.50
