sappystick/ARX/stl/shaft_handle/BAT_B2_end_cap_with_latch.stl

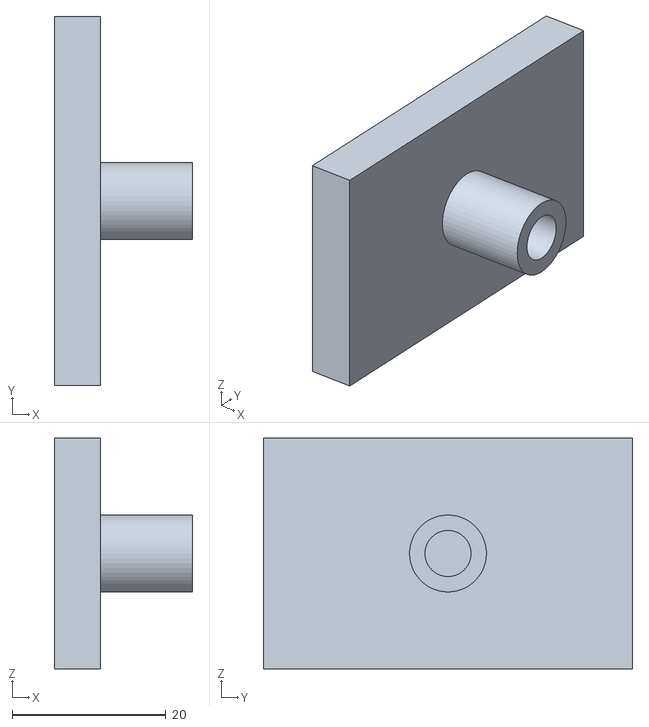
[picture p36: CAD file, 2026-10-23]
stl/shaft_handle/BAT_B2_end_cap_with_latch.stl
18.0 x 48.0 x 30.0
