sappystick/ARX/stl/shaft_handle/CAS_R1_cassette_segment_150.stl

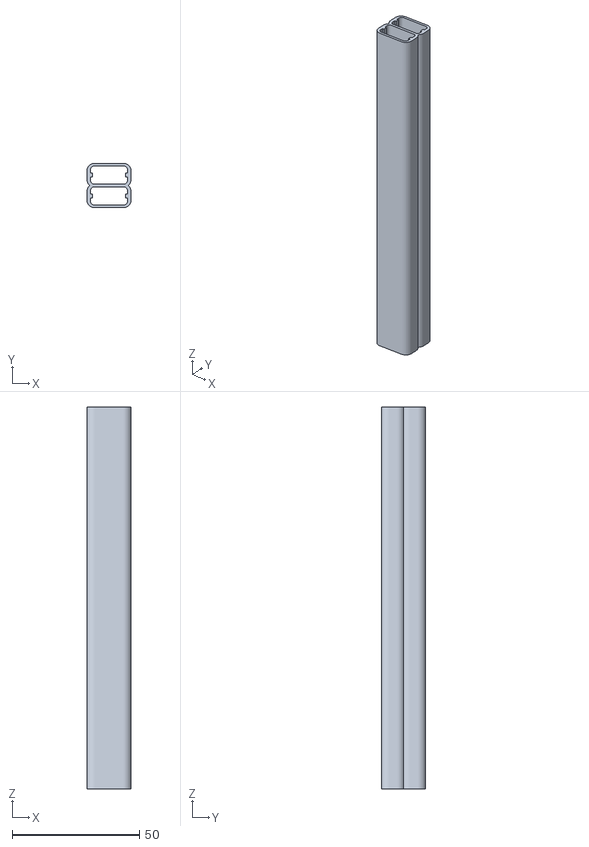
[picture p37: CAD file, 2026-10-23]
stl/shaft_handle/CAS_R1_cassette_segment_150.stl
17.4 x 17.4 x 150.0
