sappystick/ARX/(list of files, cad)

Other CAD files:
stl/pins/PIN_interface4_n18_315.1deg.stl
data/legacy/PHIFOLD233_FINAL_KIT_v3/04_PCB_receiver_AB1A/PF233-AB1A_board_with_components.stl
data/legacy/PHIFOLD233_FINAL_KIT_v3/05_PCB_receiver_AB1B/PF233-AB1B_board_with_components.stl
data/legacy/PHIFOLD233_FINAL_KIT_v4/03_POWER_BOARD_PM1/PF233-PM1_board_with_components.stl
data/legacy/PHIFOLD233_FINAL_KIT_v4/04_POWER_BOARD_PB1/PF233-PB1_board_with_components.stl
data/results/hood_tile_cut_sheet.dxf
