sappystick/ARX/data/results/TEST_PLAN.csv

id | test | method / instrument | expected / pass criterion | applies to
T01 | continuity of every conductor | 4-wire ohm meter, 10 mA | AWG28 1.72 m = 0.37 ohm per conductor (3 in parallel 0.122 ohm); 8-way ribbon 0.8 m = 0.17 ohm; no open | all ribbon rows in HARNESS_MASTER.csv
T02 | power ribbon voltage drop | 2 A DC through VBUS and GND legs | drop <= 0.49 V (two legs, three conductors each) | power ribbon
T03 | signal ribbon cross-talk | 1 V, 10 kHz on TRIG, measure DIAL | < -50 dB | signal ribbon
T04 | TX1_IN edge integrity at the head end | scope, 3.3 V, 1.7 m path with 33 ohm series | rise < 10 ns, no ring above 4.0 V | 8-way ribbon
T05 | TX pair hipot | 1 kV DC, 60 s, pair to foil and to every other conductor | leakage < 1 uA | TX pair
T06 | TX pair pulse test | 20 A, 41.5 us, 400 Hz into the real coil, 10 min | turn-off < 2.5 us, coil + pair inductance within 54 uH +1.5 uH, no hot spot (IR) above 40 C | TX pair, PB1R, coil
T07 | antenna monitor level | scope on CB1D JHTA at 20 A turn-off | peak <= 20 V before the 10 k + clamp; after the clamp <= 3.6 V | HTA
T08 | display bring-up | 66-pixel chase, then 5 target patterns at the real brightness cap | average LED current <= 50 mA (about 0.25 W) | LB1
T09 | receive null | with TX on, all 5 receive channels in blank, then ungated | residual per channel < 1% of the unnulled value, then trimmed by the calibration table | SB1R + AB1A/B
T10 | isolation between chambers | 500 V DC between chambers P, S and the foil lining | > 100 Mohm | shaft cassette
T11 | ribbon life | trolley cycles 0.37 m stroke, 10 000 cycles, then T01 | resistance change < 5%, no cracks | power and signal ribbons
T12 | anchor pull | 20 N on each ribbon end anchor | no slip | CAS_R3 anchors
T13 | telescoping joint | extend / collapse 500 cycles; lock collar torque | no binding; 25 N holds the extension without slip | tubes A and B, bushings, lock collar
T14 | hinge detent | clamp the hinge at 10 deg steps, 15 N m shaft torque | no slip; serration teeth intact | hinge arm, lugs
T15 | head leak test | 20 kPa pressure decay after the skirt is filled | < 0.5 kPa in 10 min | head, skirt, cap
T16 | neck module thermal | 20 A, 400 Hz for 30 min in 25 C air | housing rise <= 20 K (calculated about 16 K) | NPM + PB1R
T17 | static offset of the neck module | scope the receive gates with the shaft clamped at 3 angles | offset change between angles < 1 gate LSB; if not, move the module up the lower tube | NPM position
