sappystick/ARX/data/results/TX_LEAD_TABLE.csv

layer | lead | port_deg | side | angular_distance_deg | channel_arc_mm | lead_length_mm | R_mohm
1 | A | 6.0 | low | 172.0 | 134.3 | 162.3 | 4.87
1 | B | 11.0 | low | 167.0 | 130.1 | 158.1 | 4.74
2 | A | 143.51 | low | 34.5 | 21.2 | 49.2 | 1.48
2 | B | 148.51 | low | 29.5 | 17.1 | 45.1 | 1.35
3 | A | 281.02 | high | 103.0 | 77.5 | 105.5 | 3.17
3 | B | 286.02 | high | 108.0 | 81.7 | 109.7 | 3.29
4 | A | 58.52 | low | 119.5 | 91.1 | 119.1 | 3.57
4 | B | 63.52 | low | 114.5 | 87.0 | 115.0 | 3.45
5 | A | 196.03 | high | 18.0 | 7.7 | 35.7 | 1.07
5 | B | 201.03 | high | 23.0 | 11.8 | 39.8 | 1.19
6 | A | 333.54 | high | 155.5 | 120.7 | 148.7 | 4.46
6 | B | 338.54 | high | 160.5 | 124.8 | 152.8 | 4.59
