sappystick/ARX/(list of files, drawings)

Other design files:
data/results/sch_check.json
