sappystick/ARX/data/kicad/legacy/PF233-AB1B.kicad_pcb

## KiCad design data/kicad/legacy/PF233-AB1B.kicad_pcb (2026-10-23, an earlier design)

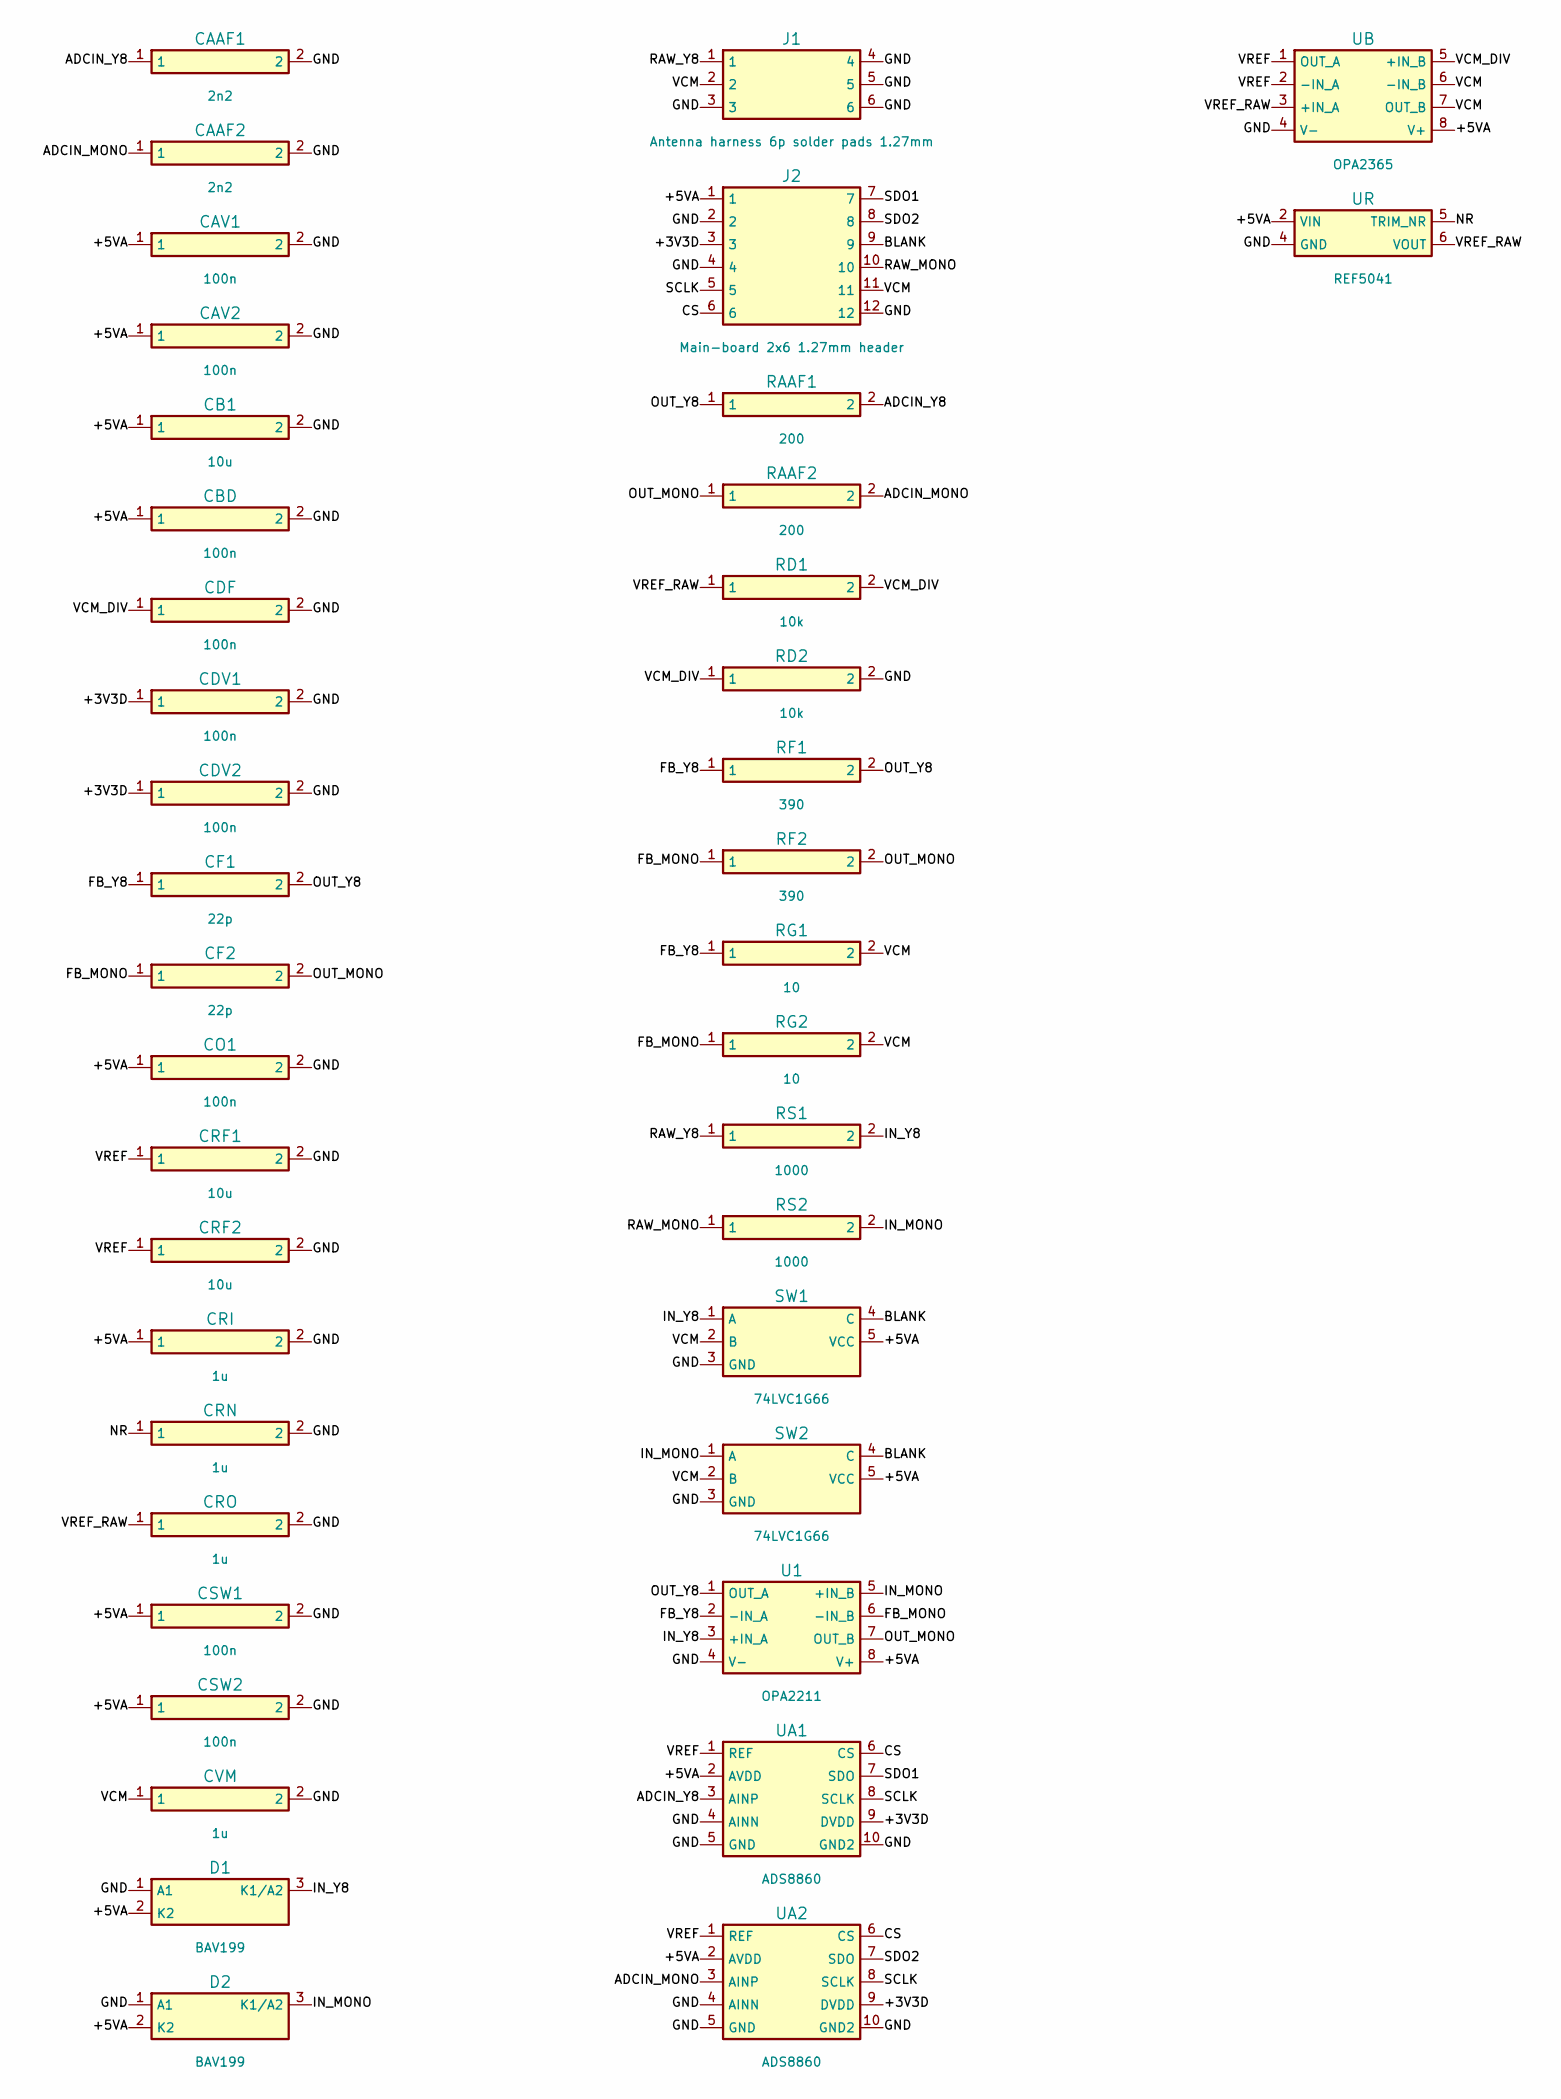
[picture p38: schematic PF233-AB1B.kicad_sch, PF233-AB1B (generated from PF233-AB1B.net)]

Parts:
CAAF1, CAAF2: 2n2; C_0603_1608Metric
CAV1, CAV2: 100n; C_0402_1005Metric
CB1: 10u; C_0805_2012Metric
CBD: 100n; C_0402_1005Metric
CDF: 100n; C_0402_1005Metric
CDV1, CDV2: 100n; C_0402_1005Metric
CF1, CF2: 22p; C_0402_1005Metric
CO1: 100n; C_0402_1005Metric
CRF1, CRF2: 10u; C_0805_2012Metric
CRI: 1u; C_0603_1608Metric
CRN: 1u; C_0603_1608Metric
CRO: 1u; C_0603_1608Metric
CSW1, CSW2: 100n; C_0402_1005Metric
CVM: 1u; C_0603_1608Metric
D1, D2: BAV199; SOT-23
J1: Antenna harness 6p solder pads 1.27mm; PinHeader_1x6_P1.27mm
J2: Main-board 2x6 1.27mm header; PinHeader_2x6_P1.27mm
RAAF1, RAAF2: 200; R_0402_1005Metric
RD1, RD2: 10k; R_0402_1005Metric
RF1, RF2: 390; R_0402_1005Metric
RG1, RG2: 10; R_0402_1005Metric
RS1, RS2: 1000; R_0402_1005Metric
SW1, SW2: 74LVC1G66; SOT-23-5
U1: OPA2211; SOIC-8_3.9x4.9mm_P1.27mm
UA1, UA2: ADS8860; MSOP-10_3x3mm_P0.5mm
UB: OPA2365; MSOP-8_3x3mm_P0.65mm
UR: REF5041; MSOP-8_3x3mm_P0.65mm

Connections:
+3V3D: CDV1.1, CDV2.1, J2.3, UA1.9 (DVDD), UA2.9 (DVDD)
+5VA: CAV1.1, CAV2.1, CB1.1, CBD.1, CO1.1, CRI.1, CSW1.1, CSW2.1, D1.2 (K2), D2.2 (K2), J2.1, SW1.5 (VCC), SW2.5 (VCC), U1.8 (V+), UA1.2 (AVDD), UA2.2 (AVDD), UB.8 (V+), UR.2 (VIN)
ADCIN_MONO: CAAF2.1, RAAF2.2, UA2.3 (AINP)
ADCIN_Y8: CAAF1.1, RAAF1.2, UA1.3 (AINP)
BLANK: J2.9, SW1.4 (C), SW2.4 (C)
CS: J2.6, UA1.6 (CS), UA2.6 (CS)
FB_MONO: CF2.1, RF2.1, RG2.1, U1.6 (-IN_B)
FB_Y8: CF1.1, RF1.1, RG1.1, U1.2 (-IN_A)
GND: CAAF1.2, CAAF2.2, CAV1.2, CAV2.2, CB1.2, CBD.2, CDF.2, CDV1.2, CDV2.2, CO1.2, CRF1.2, CRF2.2, CRI.2, CRN.2, CRO.2, CSW1.2, CSW2.2, CVM.2, D1.1 (A1), D2.1 (A1), J1.3, J1.4, J1.5, J1.6, J2.2, J2.4, J2.12, RD2.2, SW1.3 (GND), SW2.3 (GND), U1.4 (V-), UA1.4 (AINN), UA1.5 (GND), UA1.10 (GND2), UA2.4 (AINN), UA2.5 (GND), UA2.10 (GND2), UB.4 (V-), UR.4 (GND)
IN_MONO: D2.3 (K1/A2), RS2.2, SW2.1 (A), U1.5 (+IN_B)
IN_Y8: D1.3 (K1/A2), RS1.2, SW1.1 (A), U1.3 (+IN_A)
NR: CRN.1, UR.5 (TRIM_NR)
OUT_MONO: CF2.2, RAAF2.1, RF2.2, U1.7 (OUT_B)
OUT_Y8: CF1.2, RAAF1.1, RF1.2, U1.1 (OUT_A)
RAW_MONO: J2.10, RS2.1
RAW_Y8: J1.1, RS1.1
SCLK: J2.5, UA1.8 (SCLK), UA2.8 (SCLK)
SDO1: J2.7, UA1.7 (SDO)
SDO2: J2.8, UA2.7 (SDO)
VCM: CVM.1, J1.2, J2.11, RG1.2, RG2.2, SW1.2 (B), SW2.2 (B), UB.6 (-IN_B), UB.7 (OUT_B)
VCM_DIV: CDF.1, RD1.2, RD2.1, UB.5 (+IN_B)
VREF: CRF1.1, CRF2.1, UA1.1 (REF), UA2.1 (REF), UB.1 (OUT_A), UB.2 (-IN_A)
VREF_RAW: CRO.1, RD1.1, UB.3 (+IN_A), UR.6 (VOUT)

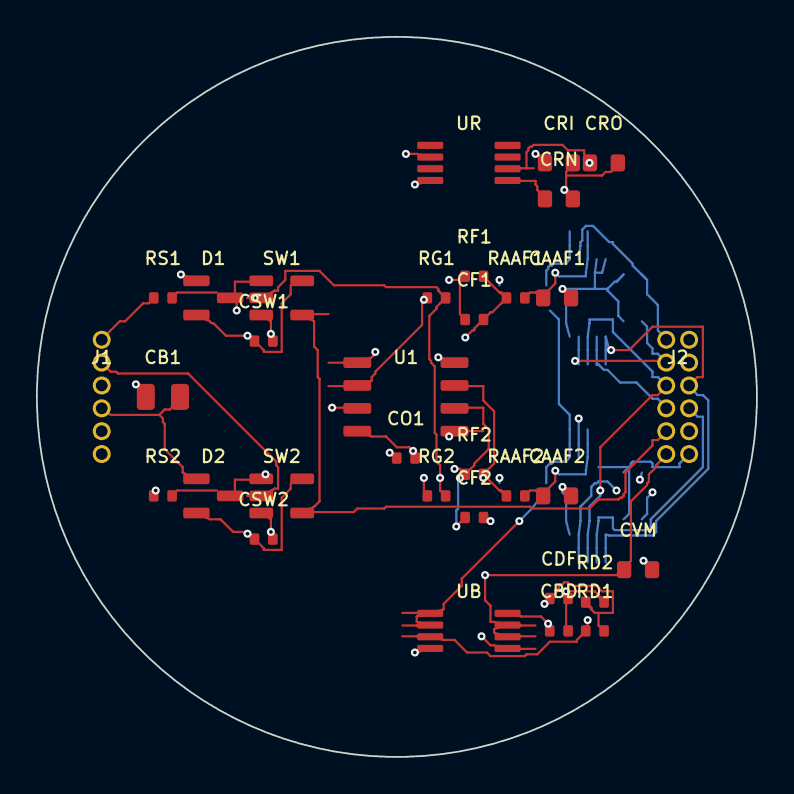
[picture p39: board PF233-AB1B.kicad_pcb from above]

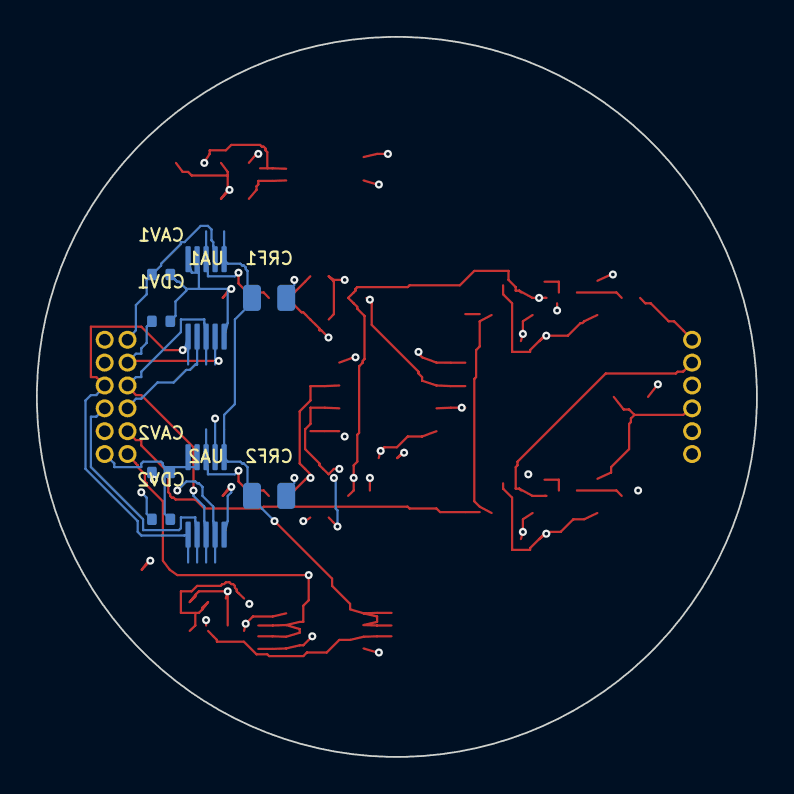
[picture p40: board PF233-AB1B.kicad_pcb from below]

Board: 6 copper layers, 40.0 x 40.0 mm, 41 parts (8 on the bottom side), 23 nets.
