sappystick/ARX/data/kicad/legacy/PF233-PB1.kicad_pcb

## KiCad design data/kicad/legacy/PF233-PB1.kicad_pcb (2026-10-23, an earlier design)

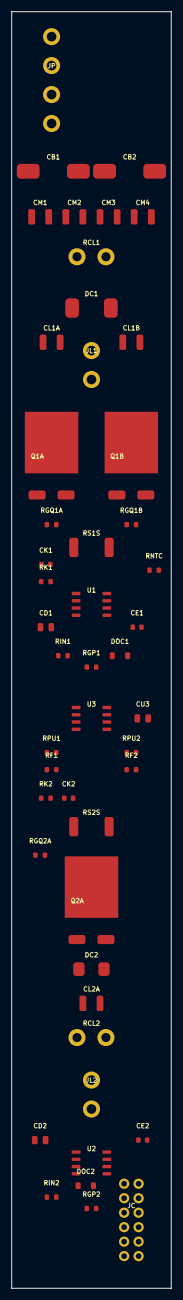
[picture p41: board PF233-PB1.kicad_pcb from above]

Board: 4 copper layers, 28.0 x 224.0 mm, 48 parts (0 on the bottom side), 27 nets, no tracks yet.

Parts:
CB1, CB2: 470u 50V; CP_Elec_10x10
CD1, CD2: 1u 25V; C_0805_2012Metric
CE1, CE2: 100n; C_0603_1608Metric
CK1, CK2: 100p; C_0603_1608Metric
CL1A, CL1B: 100n 630V; C_1210_3225Metric
CL2A: 1u 100V; C_1210_3225Metric
CM1, CM2, CM3, CM4: 10u 50V; C_1210_3225Metric
CU3: 1u 25V; C_0805_2012Metric
DC1: ES3J 600V 3A; D_SMC
DC2: ES2D 200V 2A; D_SMB
DOC1, DOC2: BAS16; D_SOD-123
JC: Controller I/F; Pin_header_2x6_P2.54mm
JL1: Coil outer: DRAIN, VBUS; Terminal_block_1x2_P5.08mm
JL2: Coil inner: DRAIN, VBUS; Terminal_block_1x2_P5.08mm
JP: Power in: VBUS VBUS GND GND; Terminal_block_1x4_P5.08mm
Q1A, Q1B: 650V SJ 95mR; TO-263-3_TabPin2
Q2A: 100V 10mR; TO-263-3_TabPin2
RCL1: external 5k 10W; SolderPad_2x_P5.08mm
RCL2: external 100R 5W; SolderPad_2x_P5.08mm
RF1, RF2: 1k; R_0603_1608Metric
RGP1, RGP2: 10k; R_0603_1608Metric
RGQ1A, RGQ1B, RGQ2A: 10; R_0603_1608Metric
RIN1, RIN2: 100; R_0603_1608Metric
RK1, RK2: 100; R_0603_1608Metric
RNTC: 10k NTC; R_0603_1608Metric
RPU1, RPU2: 10k; R_0603_1608Metric
RS1S, RS2S: 10m 3W; R_2512_6332Metric
U1, U2: TC4420; SOIC-8_3.9x4.9mm_P1.27mm
U3: LM393; SOIC-8_3.9x4.9mm_P1.27mm

Connections:
AUX12: CD1.1, CD2.1, CE1.1, CE2.1, CU3.1, JC.1, RPU1.2, RPU2.2, U1.1, U1.8, U2.1, U2.8, U3.8
CLAMP1: CL1A.1, CL1B.1, DC1.1, RCL1.1
CLAMP2: CL2A.1, DC2.1, RCL2.1
DRAIN1: DC1.2, JL1.1, Q1A.2, Q1B.2
DRAIN2: DC2.2, JL2.1, Q2A.2
DRVIN1: DOC1.2, RIN1.2, U1.2
DRVIN2: DOC2.2, RIN2.2, U2.2
FAULT1_N: JC.7, RF1.2
FAULT2_N: JC.8, RF2.2
G1: RGP1.1, RGQ1A.1, RGQ1B.1, U1.6, U1.7
G2: RGP2.1, RGQ2A.1, U2.6, U2.7
GATE_Q1A: Q1A.1, RGQ1A.2
GATE_Q1B: Q1B.1, RGQ1B.2
GATE_Q2A: Q2A.1, RGQ2A.2
GND: CB1.2, CB2.2, CD1.2, CD2.2, CE1.2, CE2.2, CK1.2, CK2.2, CM1.2, CM2.2, CM3.2, CM4.2, CU3.2, JC.2, JC.12, JP.3, JP.4, RGP1.2, RGP2.2, RNTC.2, RS1S.2, RS2S.2, U1.4, U1.5, U2.4, U2.5, U3.4
ISENSE1: CK1.1, JC.9, RK1.2, U3.2
ISENSE2: CK2.1, JC.10, RK2.2, U3.6
NTC_SENSE: JC.11, RNTC.1
OC1_OUT: DOC1.1, RF1.1, RPU1.1, U3.1
OC2_OUT: DOC2.1, RF2.1, RPU2.1, U3.7
REF_I1: JC.5, U3.3
REF_I2: JC.6, U3.5
SRC1: Q1A.3, Q1B.3, RK1.1, RS1S.1
SRC2: Q2A.3, RK2.1, RS2S.1
TX1_IN: JC.3, RIN1.1
TX2_IN: JC.4, RIN2.1
VBUS: CB1.1, CB2.1, CL1A.2, CL1B.2, CL2A.2, CM1.1, CM2.1, CM3.1, CM4.1, JL1.2, JL2.2, JP.1, JP.2, RCL1.2, RCL2.2
