sappystick/ARX/data/legacy/PHIFOLD233_KIT_v6_ARCHITECTURE/HB1/PF233-HB1.kicad_pcb

## KiCad design data/legacy/PHIFOLD233_KIT_v6_ARCHITECTURE/HB1/PF233-HB1.kicad_pcb (2026-10-23, an earlier design)

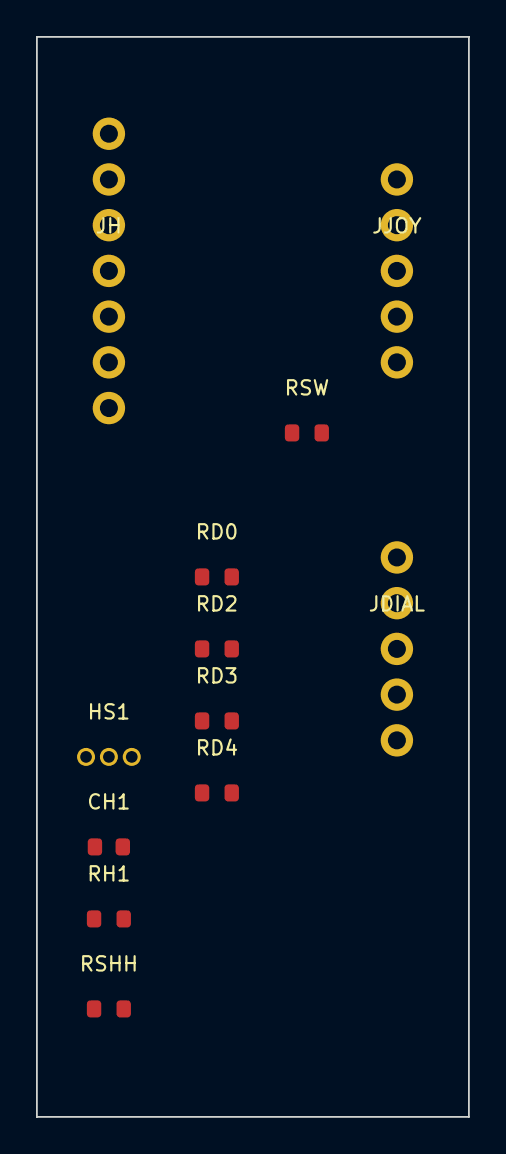
[picture p42: board PF233-HB1.kicad_pcb from above]

Board: 4 copper layers, 24.0 x 60.0 mm, 12 parts (0 on the bottom side), 12 nets, no tracks yet.

Parts:
CH1: 100n; C_0603_1608Metric
HS1: SS49E; TO-92_Inline
JDIAL: Dial: COM P1 P2 P3 P4 (4-position rotary switch); Pin_header_1x5_P2.54mm
JH: Cable to head: +3V3 GND TRIG DIAL JOYX JOYY SHLD; Pin_header_1x7_P2.54mm
JJOY: Joystick: V GND X Y SW; Pin_header_1x5_P2.54mm
RD0, RD3: 10k; R_0603_1608Metric
RD2: 3k3; R_0603_1608Metric
RD4: 33k; R_0603_1608Metric
RH1: 1k; R_0603_1608Metric
RSHH: 0R; R_0603_1608Metric
RSW: 10k; R_0603_1608Metric

Connections:
DIAL: JDIAL.1, JH.4, RD0.2
DP2: JDIAL.3, RD2.1
DP3: JDIAL.4, RD3.1
DP4: JDIAL.5, RD4.1
GND: CH1.2, HS1.2, JDIAL.2, JH.2, JJOY.2, RD2.2, RD3.2, RD4.2, RSHH.2
HALL_OUT: HS1.3, RH1.1
JOY_SW: JJOY.5, RSW.1
JOY_X: JH.5, JJOY.3
JOY_Y: JH.6, JJOY.4
P3V3: CH1.1, HS1.1, JH.1, JJOY.1, RD0.1, RSW.2
SHIELD: JH.7, RSHH.1
TRIG: JH.3, RH1.2
