sappystick/ARX/data/kicad/PF233-CB1D_routed.kicad_pcb

## KiCad design data/kicad/PF233-CB1D_routed.kicad_pcb (2026-10-23)

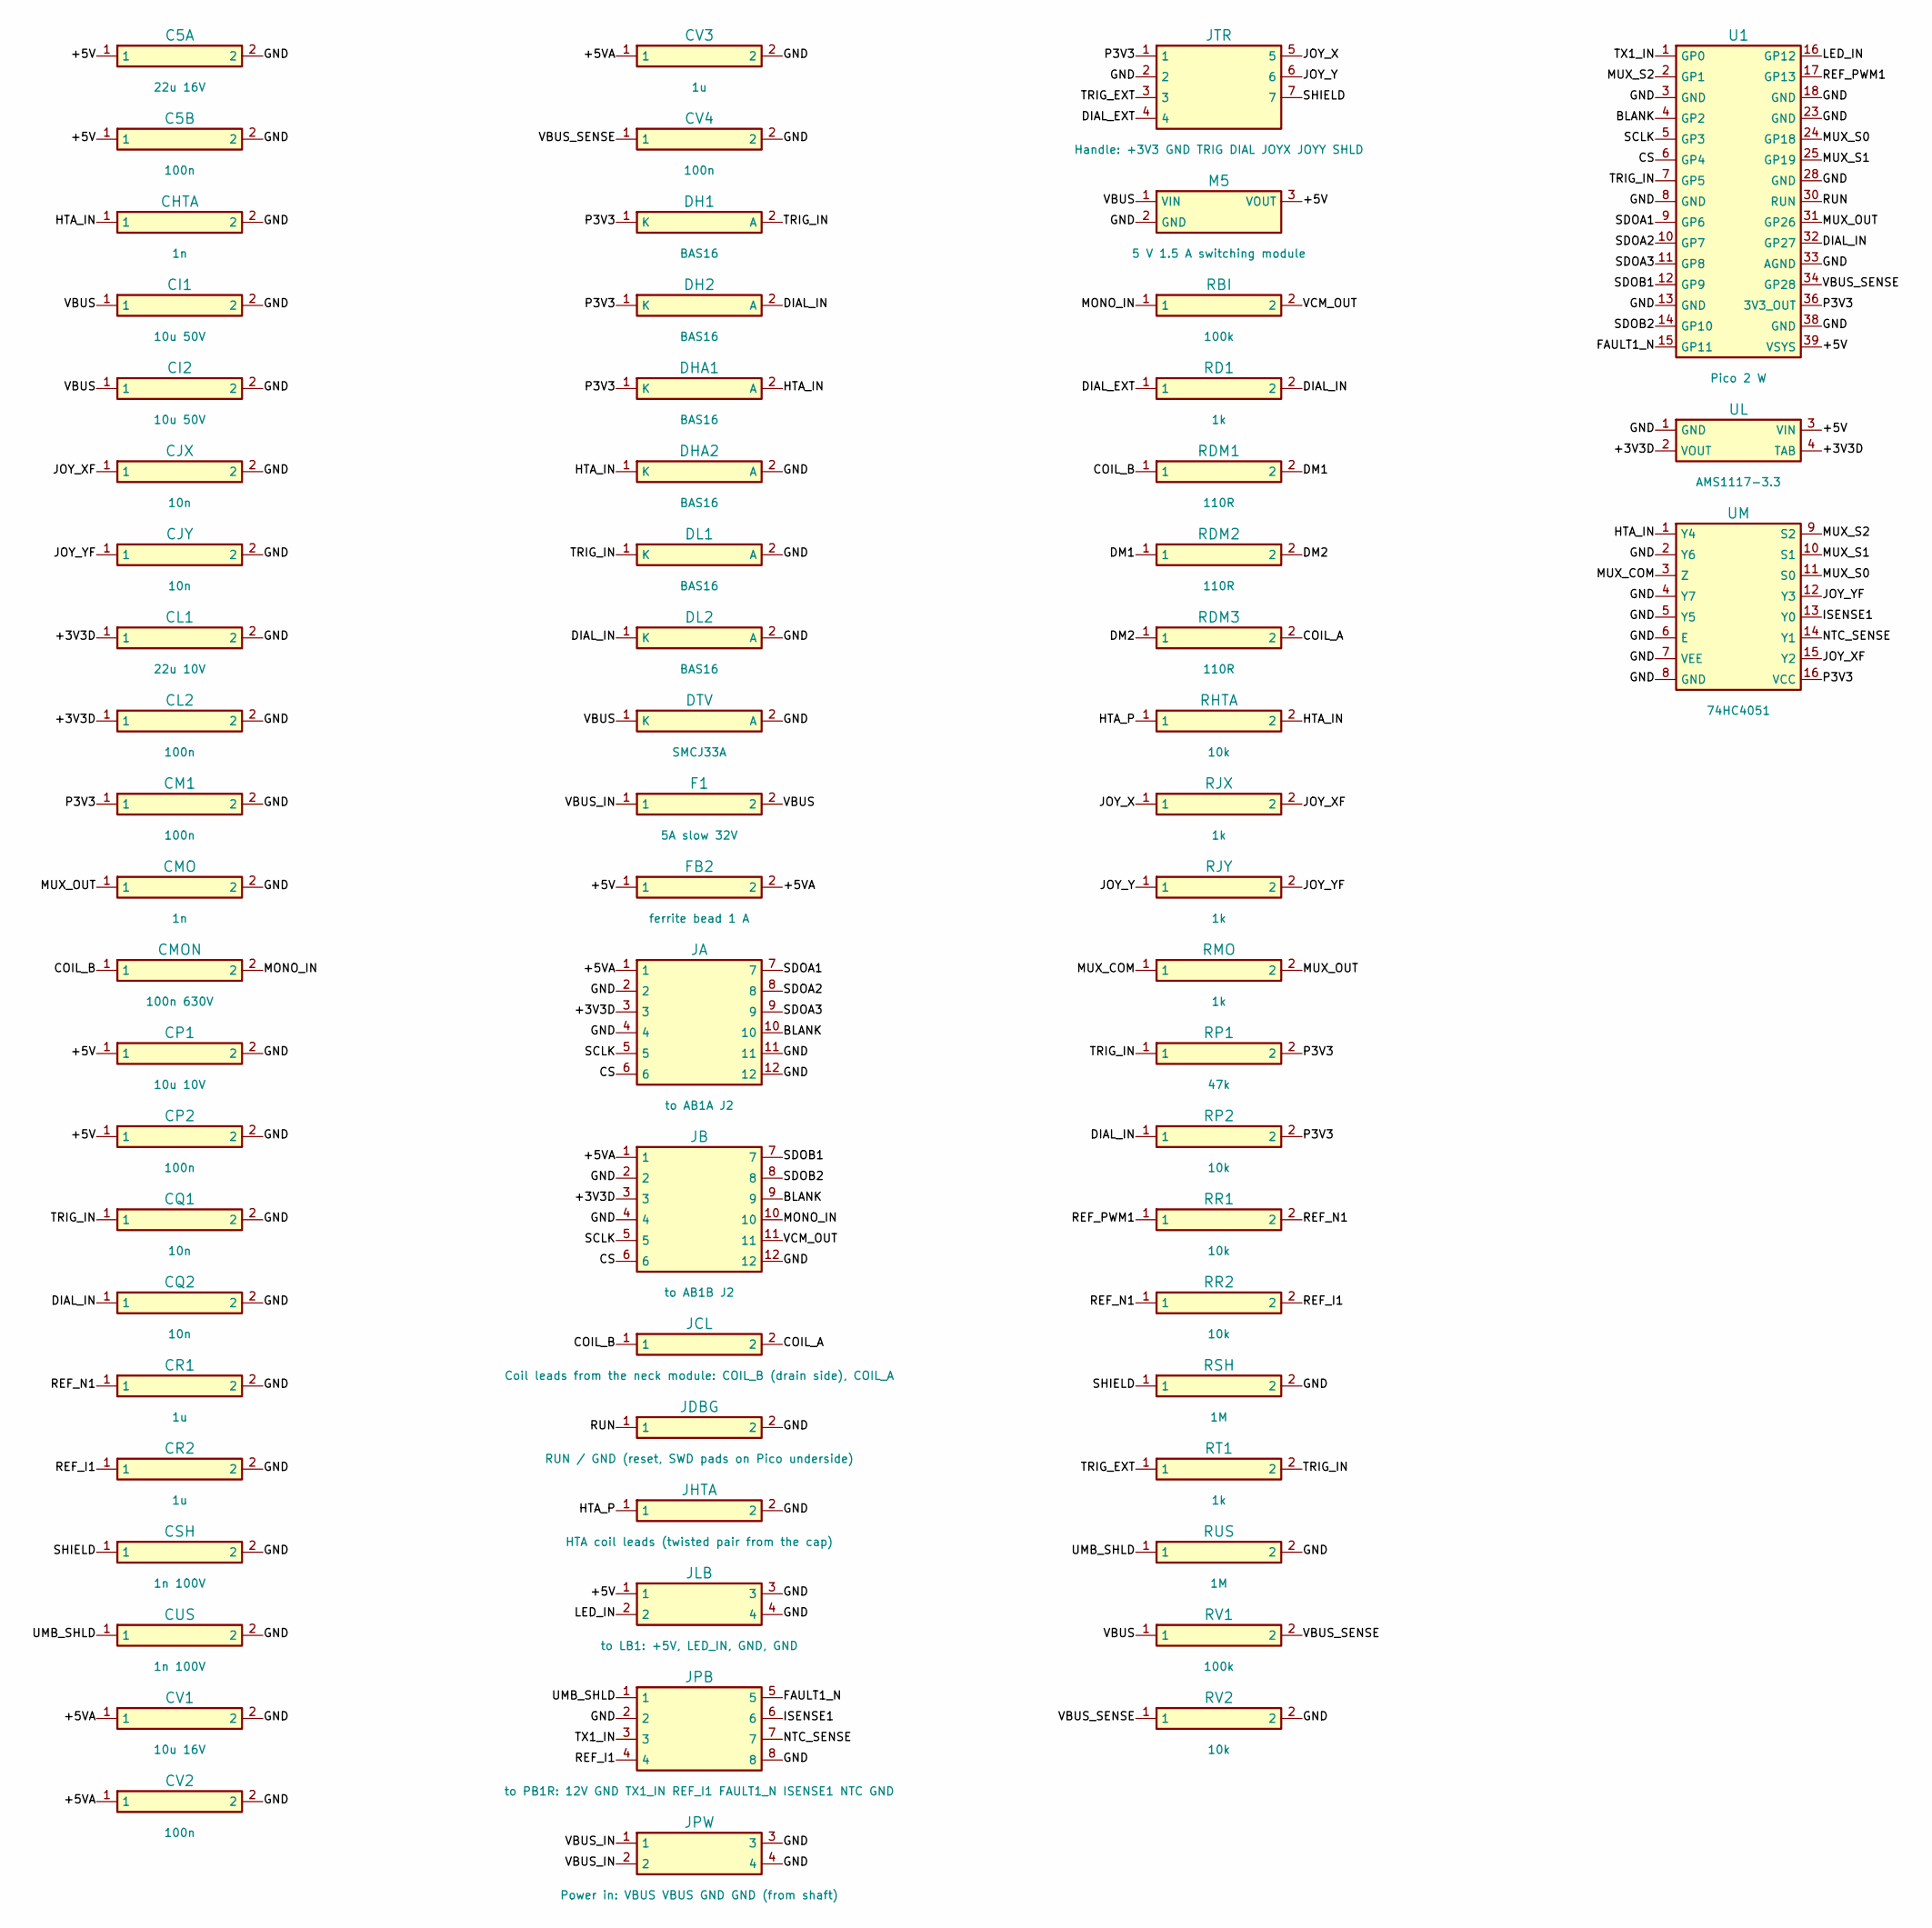
[picture p43: schematic PF233-CB1D.kicad_sch, PF233-CB1D (generated from PF233-CB1D.net)]

Parts:
C5A: 22u 16V; C_1210_3225Metric
C5B: 100n; C_0603_1608Metric
CHTA: 1n; C_0603_1608Metric
CI1, CI2: 10u 50V; C_1210_3225Metric
CJX: 10n; C_0603_1608Metric
CJY: 10n; C_0603_1608Metric
CL1: 22u 10V; C_1210_3225Metric
CL2: 100n; C_0603_1608Metric
CM1: 100n; C_0603_1608Metric
CMO: 1n; C_0603_1608Metric
CMON: 100n 630V; C_1210_3225Metric
CP1: 10u 10V; C_0805_2012Metric
CP2: 100n; C_0603_1608Metric
CQ1, CQ2: 10n; C_0603_1608Metric
CR1, CR2: 1u; C_0603_1608Metric
CSH: 1n 100V; C_0603_1608Metric
CUS: 1n 100V; C_0603_1608Metric
CV1: 10u 16V; C_1210_3225Metric
CV2, CV4: 100n; C_0603_1608Metric
CV3: 1u; C_0805_2012Metric
DH1, DH2: BAS16; D_SOD-123
DHA1, DHA2: BAS16; D_SOD-123
DL1, DL2: BAS16; D_SOD-123
DTV: SMCJ33A; D_SMC
F1: 5A slow 32V; Fuse_1812_4532Metric
FB2: ferrite bead 1 A; L_1812_4532Metric
JA: to AB1A J2; Pin_header_1.27_2x6_P1.27mm
JB: to AB1B J2; Pin_header_1.27_2x6_P1.27mm
JCL: Coil leads from the neck module: COIL_B (drain si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; Terminal_block_1x2_P5.08mm
JDBG: RUN / GND (reset, SWD pads on Pico underside); Pin_header_1x2_P2.54mm
JHTA: HTA coil leads (twisted pair from the cap); SolderPad_2x_P5.08mm
JLB: to LB1: +5V, LED_IN, GND, GND; Pin_header_1x4_P2.54mm
JPB: to PB1R: 12V GND TX1_IN REF_I1 FAULT1_N ISENSE1 N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; Pin_header_2x4_P2.54mm
JPW: Power in: VBUS VBUS GND GND (from shaft); Terminal_block_1x4_P5.08mm
JTR: Handle: +3V3 GND TRIG DIAL JOYX JOYY SHLD; Pin_header_1x7_P2.54mm
M5: 5 V 1.5 A switching module; Converter_DCDC_Murata_OKI-78SR_Horizontal
RBI: 100k; R_0603_1608Metric
RD1: 1k; R_0603_1608Metric
RDM1, RDM2, RDM3: 110R; R_2512_6332Metric
RHTA: 10k; R_0603_1608Metric
RJX: 1k; R_0603_1608Metric
RJY: 1k; R_0603_1608Metric
RMO: 1k; R_0603_1608Metric
RP1: 47k; R_0603_1608Metric
RP2: 10k; R_0603_1608Metric
RR1, RR2: 10k; R_0603_1608Metric
RSH: 1M; R_0603_1608Metric
RT1: 1k; R_0603_1608Metric
RUS: 1M; R_0603_1608Metric
RV1: 100k; R_0603_1608Metric
RV2: 10k; R_0603_1608Metric
U1: Pico 2 W; RaspberryPi_Pico_Common_THT
UL: AMS1117-3.3; SOT-223-3_TabPin2
UM: 74HC4051; SOIC-16_3.9x9.9mm_P1.27mm

Connections:
+3V3D: CL1.1, CL2.1, JA.3, JB.3, UL.2 (VOUT), UL.4 (TAB)
+5V: C5A.1, C5B.1, CP1.1, CP2.1, FB2.1, JLB.1, M5.3 (VOUT), U1.39 (VSYS), UL.3 (VIN)
+5VA: CV1.1, CV2.1, CV3.1, FB2.2, JA.1, JB.1
BLANK: JA.10, JB.9, U1.4 (GP2)
COIL_A: JCL.2, RDM3.2
COIL_B: CMON.1, JCL.1, RDM1.1
CS: JA.6, JB.6, U1.6 (GP4)
DIAL_EXT: JTR.4, RD1.1
DIAL_IN: CQ2.1, DH2.2 (A), DL2.1 (K), RD1.2, RP2.1, U1.32 (GP27)
DM1: RDM1.2, RDM2.1
DM2: RDM2.2, RDM3.1
FAULT1_N: JPB.5, U1.15 (GP11)
GND: C5A.2, C5B.2, CHTA.2, CI1.2, CI2.2, CJX.2, CJY.2, CL1.2, CL2.2, CM1.2, CMO.2, CP1.2, CP2.2, CQ1.2, CQ2.2, CR1.2, CR2.2, CSH.2, CUS.2, CV1.2, CV2.2, CV3.2, CV4.2, DHA2.2 (A), DL1.2 (A), DL2.2 (A), DTV.2 (A), JA.2, JA.4, JA.11, JA.12, JB.2, JB.4, JB.12, JDBG.2, JHTA.2, JLB.3, JLB.4, JPB.2, JPB.8, JPW.3, JPW.4, JTR.2, M5.2 (GND), RSH.2, RUS.2, RV2.2, U1.3 (GND), U1.8 (GND), U1.13 (GND), U1.18 (GND), U1.23 (GND), U1.28 (GND), U1.33 (AGND), U1.38 (GND), UL.1 (GND), UM.2 (Y6), UM.4 (Y7), UM.5 (Y5), UM.6 (E), UM.7 (VEE), UM.8 (GND)
HTA_IN: CHTA.1, DHA1.2 (A), DHA2.1 (K), RHTA.2, UM.1 (Y4)
HTA_P: JHTA.1, RHTA.1
ISENSE1: JPB.6, UM.13 (Y0)
JOY_X: JTR.5, RJX.1
JOY_XF: CJX.1, RJX.2, UM.15 (Y2)
JOY_Y: JTR.6, RJY.1
JOY_YF: CJY.1, RJY.2, UM.12 (Y3)
LED_IN: JLB.2, U1.16 (GP12)
MONO_IN: CMON.2, JB.10, RBI.1
MUX_COM: RMO.1, UM.3 (Z)
MUX_OUT: CMO.1, RMO.2, U1.31 (GP26)
MUX_S0: U1.24 (GP18), UM.11 (S0)
MUX_S1: U1.25 (GP19), UM.10 (S1)
MUX_S2: U1.2 (GP1), UM.9 (S2)
NTC_SENSE: JPB.7, UM.14 (Y1)
P3V3: CM1.1, DH1.1 (K), DH2.1 (K), DHA1.1 (K), JTR.1, RP1.2, RP2.2, U1.36 (3V3_OUT), UM.16 (VCC)
REF_I1: CR2.1, JPB.4, RR2.2
REF_N1: CR1.1, RR1.2, RR2.1
REF_PWM1: RR1.1, U1.17 (GP13)
RUN: JDBG.1, U1.30 (RUN)
SCLK: JA.5, JB.5, U1.5 (GP3)
SDOA1: JA.7, U1.9 (GP6)
SDOA2: JA.8, U1.10 (GP7)
SDOA3: JA.9, U1.11 (GP8)
SDOB1: JB.7, U1.12 (GP9)
SDOB2: JB.8, U1.14 (GP10)
SHIELD: CSH.1, JTR.7, RSH.1
TRIG_EXT: JTR.3, RT1.1
TRIG_IN: CQ1.1, DH1.2 (A), DL1.1 (K), RP1.1, RT1.2, U1.7 (GP5)
TX1_IN: JPB.3, U1.1 (GP0)
UMB_SHLD: CUS.1, JPB.1, RUS.1
VBUS: CI1.1, CI2.1, DTV.1 (K), F1.2, M5.1 (VIN), RV1.1
VBUS_IN: F1.1, JPW.1, JPW.2
VBUS_SENSE: CV4.1, RV1.2, RV2.1, U1.34 (GP28)
VCM_OUT: JB.11, RBI.2

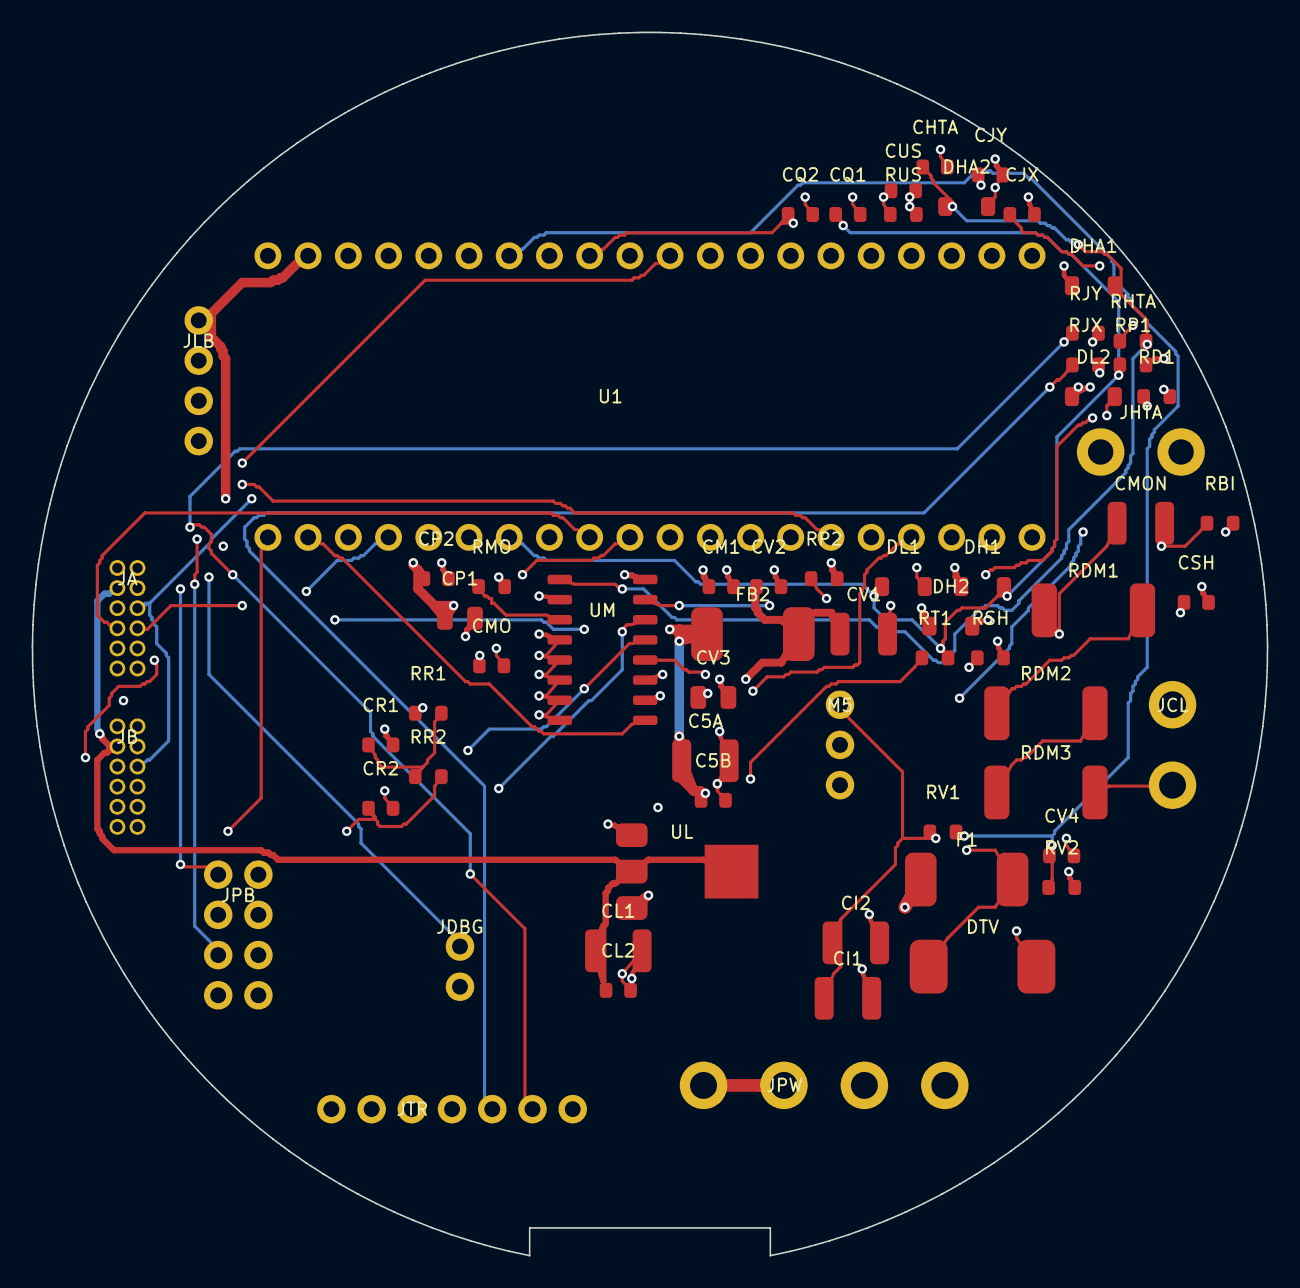
[picture p44: board PF233-CB1D_routed.kicad_pcb from above]

Board: 6 copper layers, 78.0 x 77.2 mm, 64 parts (0 on the bottom side), 48 nets.
