sappystick/ARX/tests/regress.py

#!/usr/bin/env python3
"""Regression: reads results written into work/ by the make targets and compares with the expected numbers. Missing result files are reported as SKIP, not PASS."""
import json, os, sys
W="work"; res=[]
def rd(p):
    try: return json.load(open(os.path.join(W,p)))
    except Exception: return None
def chk(name,ok,detail=""): res.append(("PASS" if ok else "FAIL",name,detail))
def skip(name): res.append(("SKIP",name,"result file not present: run the matching make target"))
d=rd("kit_v22/check_v22.json")
if d: bad=[c["check"] for c in d["checks"] if c["result"]!="PASS"]; chk("v5 geometry checks (47 expected: cylinder, TX-lead channel, roof, tray, septum, comb, bosses, base plate, receive-board holes, QB lead access, damping resistors)",len(d["checks"])>=47 and not bad,f"{len(d['checks'])} checks, fails={bad}")
else: skip("v5 geometry checks")
d=rd("kit_v20/sim_head1.json")
if d:
    chk("coil moment 7.96 A m2 at 20 A (+-2%)",abs(d["tx_moment"]["moment_Am2_at_20A"]-7.96)<0.16,str(d["tx_moment"]))
    g=d["first_clean_gate_us"]; x=g["100 nF C0G/film"]["X8"]; chk("first clean gate X8 film 7.94 us (+-0.5)",abs(x-7.94)<0.5,str(x))
    s=d["improvement_steps_X8_depth_mm"]["RS3 -> 100 ohm"]["1.0 g"]; chk("X8 1 g depth with 100 ohm 179 mm (+-6)",abs(s-179)<6,str(s))
else: skip("sim_head1 results")
d=rd("kit_v21/sim_tanr.json")
if d:
    pv=d["peak_volts_at_turnoff"]; chk("figure-8 off 0.5 mm leaks > 100x the quadrupole",pv["X8 figure-8"]["shift 0.5,0 mm"]>100*pv["QUAD A (quadrants)"]["shift 0.5,0 mm"],str(pv["X8 figure-8"]["shift 0.5,0 mm"]))
else: skip("sim_tanr results")
d=rd("kit_v21/sim_quadbearing.json")
if d:
    v=list(d.values()); chk("quad pair RSS flat within 3% over azimuth",all(x["amp_ratio_max_min"]<1.03 for x in v),str([x["amp_ratio_max_min"] for x in v]))
else: skip("quad bearing results")
d=rd("kit_v22/parts_report.json")
if d: chk("v5 parts closed meshes",all(v["nonmanifold_edges"]==0 for v in d.values()),str({k:v["nonmanifold_edges"] for k,v in d.items()}))
d=rd("kit_v20/route_LB1.json")
if d: st=d["stats"]; chk("LB1 routed 68/68 nets, no failures",st["nets_routed"]==st["nets_to_route"]==68 and not st["failures"],str(st))
else: skip("LB1 routing")
d=rd("kit_v18/PARTS/hood_v3_report.json")
if d: a=d["hood_v3_audit"]; chk("hood v3: 26 tiles butted 0.2 mm, spoke gap >= 1.7 mm, corner r <= 116.1, all generator checks pass",a["tiles"]==26 and a["min_tile_gap"]>=1.7 and a["outer_frame_corner_r"]<=116.1 and all(c["result"]=="PASS" for c in d["checks"]),str({k:a[k] for k in ("min_tile_gap","butt_joint","outer_frame_corner_r","mass_g","dims")}))
else: skip("hood audit")
d=rd("kit_v22/hood_axi.json")
if d:
    v=d["validation_no_hood"]; vv=d["variants"]; v3=next(k for k in vv if k.startswith("v3")); v2=next(k for k in vv if k.startswith("v2"))
    chk("hood model: no-hood axis field within 0.5 % of Biot-Savart (50-300 mm)",all(abs(v[k]["dev_pct"])<0.5 for k in ("50","100","150","200","300")),str({k:v[k]["dev_pct"] for k in v}))
    chk("hood v3 gain at 200 mm 12.5-14.5 % (series model; v2 9.5-10.2 %), tiles below 100 mT at 20 A",12.5<=vv[v3]["lower"]["200"]<=14.5 and 9.5<=vv[v2]["lower"]["200"]<=10.2 and vv[v3]["Bmax_in_tiles_mT_at_20A"]<100,f"v3 {vv[v3]['lower']['200']}-{vv[v3]['upper']['200']} %, v2 {vv[v2]['lower']['200']}-{vv[v2]['upper']['200']} %, Bmax {vv[v3]['Bmax_in_tiles_mT_at_20A']} mT")
else: skip("hood model")
d=rd("kit_v19/yoke_check.json")
if d: bad=[c["check"] for c in d["checks"] if c["result"]!="PASS"]; chk("yoke checks all pass",not bad,str(bad[:3]))
else: skip("yoke checks")
d=rd("kit_v23/upper_check.json")
if d:
    bad=[c["check"] for c in d["checks"] if c["result"]!="PASS"]; chk("upper assembly v1: all checks pass (57 expected: meshes, grip, trigger, dock rails, pack bays, latch, twin cavity, tubes, interference, balance)",len(d["checks"])>=57 and not bad,f"{len(d['checks'])} checks, fails={bad[:3]}")
    b=d["balance"]; chk("upper assembly v1: torque about the grip at the v20 head reach <= v20, mass <= 1.6 kg incl. pack",b["new_47deg_working"]<=b["baseline_v20_kg_m"] and d["mass"]["upper_total_kg"]<=1.6,f"{b['new_47deg_working']} vs {b['baseline_v20_kg_m']} kg m, {d['mass']['upper_total_kg']} kg")
else: skip("upper assembly")
d=rd("kit_v23/power_dock_check.json")
if d: bad=[c["check"] for c in d["checks"] if c["result"]!="PASS"]; chk("PM2 battery dock: interlock (on only when seated AND switched), gate drive, soft start, ratings, runtime (12 checks)",len(d["checks"])>=12 and not bad,f"ramp {d['soft_start']['ramp_ms']} ms, inrush {d['soft_start']['inrush_A']} A, boost {d['runtime']['boost_h_one_pack']} h/pack, fails={bad[:2]}")
else: skip("PM2 battery dock")
d=rd("kit_v23/config_study.json")
if d:
    c=list(d["configs"].values()); c0=c[0]
    chk("configuration study: 4 configs; C1 lighter and lower torque than C0, C2 earlier first gate, C3 longer runtime (modeled)",len(c)==4 and c[1]["mass_kg"]["total"]<c0["mass_kg"]["total"] and c[1]["torque_47deg_kg_m"]<c0["torque_47deg_kg_m"] and c[2]["first_gate_us"]["worst_leak"]<c0["first_gate_us"]["worst_leak"] and c[3]["runtime_h"]["boost"]>c0["runtime_h"]["boost"],
        str({k.split(" ")[0]:(v["depth_mm_worst_leak"]["1.0 g"],v["first_gate_us"]["worst_leak"],v["mass_kg"]["total"],v["torque_47deg_kg_m"],v["runtime_h"]["boost"]) for k,v in d["configs"].items()}))
else: skip("configuration study")
d=rd("kit_v23/system_compat.json")
if d: chk("system compatibility matrix: no incompatibility (ACTION and DATA rows are listed changes and unverified facts)",d["summary"]["FAIL"]==0,str(d["summary"]))
else: skip("system compatibility")
d=rd("kit_v23/target_field.json")
if d:
    v=d["validation"]; ds=list(d["designs"].values()); a=ds[1]
    chk("target-field winding study: equivalent loops match the real-path axis field (<0.5 %) and 54 uH (<5 %); as-built within 5 % of the optimum energy and field",
        all(abs(x["dev_pct"])<0.5 for x in v["axis_field"].values()) and abs(v["L_equivalent_uH"]/v["L_repo_uH"]-1)<0.05 and abs(a["L_uH"]/ds[0]["L_uH"]-1)<0.05 and all(abs(x-1)<0.05 for x in a["field_ratio_vs_as_built"].values()),
        f"L {ds[0]['L_uH']} -> {a['L_uH']} uH, field at 200 mm x{a['field_ratio_vs_as_built']['r0 z200']}")
else: skip("target-field study")
d=rd("kit_v22/sbq_sim.json")
if d:
    L=d["leak"]; worst=max(v["peak_V"] for b in L.values() for k,v in b.items() if "lobes only" not in k and "0.5" in k)
    chk("SB1R-Q modeled leak at 0.5 mm offset below 20 mV (figure-8: 630 mV)",worst<0.02,f"{worst*1e3:.1f} mV")
    chk("SB1R-Q inductance 176 uH (+-10%) and R 10.4 ohm 1 oz",abs(d["L_uH"]-176)<18 and abs(d["R_1oz_ohm"]-10.4)<1.5,f"L {d['L_uH']} uH, R {d['R_1oz_ohm']}")
    chk("SB1R-Q pair flat within 7% and bearing scatter under 2 deg",all(v["rss_flat_max_over_min"]<1.07 and v["bearing_scatter_deg"]<2.0 for v in d["pattern"].values()),str([(v["rss_flat_max_over_min"],v["bearing_scatter_deg"]) for v in d["pattern"].values()]))
else: skip("SB1R-Q simulation")
d=rd("kit_v22/sbq_geometry.json")
if d: chk("SB1R-Q geometry: via margin >= 0.3, hole margin >= 0.5, equal lobe area-turns",d["via_margin_mm"]>=0.3 and d["hole_margin_mm"]>=0.5 and len({abs(a) for a in d["area_turns_mm2"]})==1,str((d["via_margin_mm"],d["hole_margin_mm"],d["area_turns_mm2"])))
if d: chk("SB1R-Q damping: RD1/RD2 fitted, QB transfer pads clear of QA copper",all(k in d.get("rd",{}) for k in ("RD1","RD2")) and d.get("transfer_margin_mm",-1)>=0 and min(d.get("rd_margin_mm",[-1]))>=0,str((d.get("transfer_margin_mm"),d.get("rd_margin_mm"))))
d=rd("kit_v22/sbq_damping2.json")
if d:
    fc=d["first_clean_gate_us"]; w=[k for k in fc if k.startswith("worst modeled") and "blank release 0 us" in k]; a=[k for k in fc if k.startswith("A aligned") and "blank release 0 us" in k]
    chk("SB1R-Q first clean gate with Rd 680, no blanking: A aligned 5.1-5.5 us, worst real leak <= 7.6 us (Cself 50-200 pF)",all(5.0<=fc[k]["Rd 680"]<=5.6 for k in a) and all(fc[k]["Rd 680"]<=7.6 for k in w) and all(fc[k]["no Rd"]>=59 for k in a+w),str([fc[k]["Rd 680"] for k in a+w]))
    n=d["gate_noise_nV_rtHz"]; chk("SB1R-Q gated noise with Rd 680 within 6% of no Rd (Cself 100 pF, gates 6-40 us)",all(v["Rd 680"]<=1.06*v["no Rd"] for k,v in n.items() if k.startswith("Cself 100")),str({k.split(", ")[1]:v["Rd 680"] for k,v in n.items() if k.startswith("Cself 100")}))
else: skip("SB1R-Q damping")
for b in ("LB1","CB1D"):
    d=rd(f"kit_v22/drc_{b}.json")
    if d: chk(f"{b} independent DRC: 0 clearance violations, 0 open nets, edge and notch clean",d["clearance_violations"]==0 and d["open_nets"]==0 and d["edge_samples"]==0 and d["notch_samples"]==0,str({k:d[k] for k in ('clearance_violations','open_nets','min_gap_by_layer')}))
    else: skip(f"{b} DRC")
d=rd("kit_v22/tx_system.json")
if d: chk("TX system: lead routing, TXJ1 and cradle checks all pass",all(c["result"]=="PASS" for c in d["checks"]),f"{len(d['checks'])} checks")
else: skip("TX system")
d=rd("kit_v22/wiring_audit.json")
if d: chk("wiring audit: every inter-board pin and harness conductor matches the netlists",not d["errors"],f"{d['link_pins']} link pins, {d['harness_conductors']} conductors, errors {len(d['errors'])}")
else: skip("wiring audit")
d=rd("kit_v22/system_budget.json")
if d: bad=[r for r in d["rows"] if r["status"]=="FAIL"]; chk("stress table: only the documented LED-rail row (needs the firmware cap) fails",len(bad)==1 and "LED" in bad[0]["part"],str([(r["part"],r["margin_pct"]) for r in bad]))
else: skip("stress table")
d=rd("kit_v22/stack_check.json")
if d: chk("board stack-up gaps all pass",all(r["result"]=="PASS" for r in d),f"{len(d)} checks")
else: skip("stack check")
d=rd("kit_v22/interference_audit.json")
if d: chk("voxel interference audit (window, bridge, junction): 0 interferences",len(d["interferences"])==0,f"{len(d['pairs'])} pairs")
else: skip("interference audit")
d=rd("kit_v22/sch_check.json")
if d: chk("KiCad schematics: 9 boards (incl. HB2, PM2), nets rebuilt from each .kicad_sch match the netlist exactly",len([v for v in d.values() if "check" in v])==9 and all(v["check"]["ok"] for v in d.values() if "check" in v),str({k:(v["check"]["nodes"] if "check" in v else "skipped") for k,v in d.items()}))
else: skip("KiCad schematics")
d=rd("kit_v22/trigger_check.json")
if d: bad=[c["check"] for c in d["checks"] if c["result"]=="FAIL"]; chk("handle inputs: trigger chain, sensor type vs GPIO, TRIG levels and time constant, dial ladder, boost stress",not bad,f"{d['levels']}, fails {bad}")
else: skip("trigger check")
d=rd("kit_v22/head_crosscheck.json")
if d: chk("full head cross-check: 0 failures (layers, radial fits, 3D interference, LED, TX, RX, wiring)",d["fails"]==0,f"{len(d['checks'])} checks, warns {d['warns']}")
else: skip("head cross-check")
d=rd("kit_v22/fine_check.json")
if d: chk("0.2 mm test: CB1D and LB1 discs and bodies clear of the cylinder",d[0][1]==0 and d[1][1]==[] and d[2][1]==0 and d[3][1]==[],str(d)[:120])
else: skip("fine check")
for r in res: print(*r)
f=sum(1 for r in res if r[0]=="FAIL"); print("FAILS",f,"SKIPS",sum(1 for r in res if r[0]=="SKIP")); sys.exit(1 if f else 0)
