sappystick/ARX/(commit log)

2026-10-23 Import Arx repo v5.3: PHI-FOLD 233 generators, data, docs, prompts
    Adds the full repository structure from Arx_repo_v5_3.zip: src/ generators
    and sims, data/ (seed, legacy kits, results, gerber, kicad), stl/ with
    MANIFEST.csv, docs/, prompts/, cowork/, tests/, Makefile and the .claude/
    commands, skills, agents and settings.
    STLs are stored as plain git binaries rather than Git LFS (.gitattributes
    changed): LFS uploads are not available from the session that made this
    import. All files are under GitHub's 100 MB limit (largest 14.8 MB).
    Verified on import: make verify-quick passes 43/43 geometry checks and
    tests/regress.py reports 0 fails (9 skips for targets not run); all 48
    MANIFEST.csv ha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
2026-10-23 Make generators run on NumPy 2.x (2D np.cross in tri2d)
    NumPy 2.x no longer accepts 2D vectors in np.cross, which made
    render_v6.tri2d raise ValueError and stopped make verify-quick at the
    base plate. The polygon-orientation test now writes the 2D cross product
    out; the arithmetic is the same, so results do not change. All other
    np.cross calls already use 3D vectors.
    Checked by running formers-low, verify-full, head-audit and pcb-release
    on numpy 2.1.3 / scipy 1.14 and on numpy 2.5.3 / scipy 1.18 (Python
    3.13): 280 of 284 outputs byte-identical (STLs, Gerbers, KiCad files,
    figures, route JSON), router state pickles hold identical data, and
    sim_tanr.json / sbq_sim.json differ only by float r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
2026-10-23 Run the yoke checks against the v5 cylinder; drop stale Git LFS docs
    yoke_check.py still loaded CORE_PCB_CYLINDER_v4_heel_exit.stl, which the
    current flow no longer generates, and no make target ran it, so
    tests/regress.py always skipped "yoke checks". It now measures the heel
    exit window on CORE_CYLINDER_v5_integrated.stl (same 178 deg window,
    z34.4-40.6) and runs as `make yoke-check`, called from verify-full after
    v5, hood and yoke. Result: 20 of 20 checks pass; the window measures
    14.1 mm at r47 on the v5 mesh (DESIGN_STATE: 13.3-15).
    The repo stores STLs as plain git binaries (.gitattributes), so README,
    prompts/P10_GITHUB.md and scripts/push_to_github.sh no longer mention or
    run Git LF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
2026-10-23 WIP: P00 review, SB1R damping resistors and QB lead access
    - docs/reviews/P00_BOOTSTRAP_2026-10-23.md: contradictions list and summary.
    - sbq_gen2/sbq_export: RD1 (0805) across QA P1/P2; QB terminals end at r23
    under two QA transfer PTHs (QB_COIL) with RD2 across them. QB pads at r33
    were covered by QA copper and had no way out.
    - sbq_tune/sbq_sim: each board uses its own pads (sbq_sim closed board B
    with board A's pads).
    - sbq_damp2.py: damping with the AB1T input network and blank-switch release
    time; sbq_damp.py archived (its "12 mV" worst case was the 187 mV
    lobes-only row).
    - check_v22: QB transfer pads, RD margins, gallery open (section test with
    a self-test), boss distance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
2026-10-23 Damping resistors 680 ohm, results, docs and regression for SB1R-Q
    - RD1/RD2 value 680 ohm (minimax first gate over Cself 50-200 pF with the
    real AB1T input): 5.1-5.5 us aligned, 7.1-7.5 us at the worst real leak
    (10 mV); gated noise +4 % at 6 us, < 2 % from 20 us. Firmware rule: keep
    BLANK open through turn-off unless the leak exceeds amplifier headroom.
    - QB leak after moving its terminals to r23 and re-tuning B (9/9/9/20/6):
    0.07 / 0.59 / 6.0 / 10.3 mV (was 0.005 / 0.85 / 4.4 / 11.0 mV).
    - Regenerated SB1R-QA/QB Gerbers and KiCad files, seeds and results;
    sbq_damping.json replaced by sbq_damping2.json; figures SBQ_DAMPING2,
    RX_PLATFORM_QUAD and LEVELS_SCHEMATIC redrawn.
    - DESI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
2026-10-23 KiCad schematics for 7 boards; fix the trigger input (digital Hall switch, 47k pull-up)
    - sch_export.py: .kicad_sch for CB1D, LB1, AB1A, AB1B, PB1R, PM1, HB1 from
    the netlists (box symbol per part, net label on every pin); sch_check
    rebuilds the nets from each file and matches the netlist exactly (7/7).
    Not opened in KiCad; no KiCad ERC. `make sch`, run from verify-full.
    - trigger_check.py: traces HB1 HS1 -> JH.3 -> W013 -> CB1D JTR.3 -> TRIG_IN
    -> Pico pin 7, checks sensor type vs GPIO type, levels, time constant,
    dial ladder at the ADC, joystick switch, boost stress rows.
    - Defects found: the linear SS49E fed a digital-only GPIO (undefined state
    at rest), and the low level thro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
2026-10-23 Enhancement review: field, coils, waveform, receive, processing
    docs/reviews/ENHANCEMENT_REVIEW_2026-10-23.md answers the review questions
    (condensing, stronger field for depth, trigger boost and sustainability,
    winding density and pattern, extra coils, waveform and sequential six-layer
    activation, receive coding and the HTA, processing chain to the audio and
    LED libraries) with modeled numbers: depth scaling from sim_head1 (SNR ~
    depth^-5.1), a winding-density table from the real TX stage at constant
    moment, per-layer field ratios from the real coil paths, and ranked
    recommendations. Docs only; nothing is measured.
    Claude-Session: htt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
2026-10-23 WIP: ferrite hood v3 (butted tiles) and the axisymmetric hood model
    - src/sim/hood_axi.py: axisymmetric magnetostatic model (flux function on an
    r-z grid, Wiener bounds on the tile homogenisation). No-hood axis field
    within 0.1 % of Biot-Savart (50-500 mm); image-method limit reproduced to
    96-97 % at 100-200 mm; 0.35 mm grid moves the gain by 0.2 points.
    - Hood gain: v2 +12.7 / +9.8 / +7.8 % at 100 / 200 / 300 mm (documented
    +6.7 / +5.3 / +4.3 % came from the unconverged dipole model); v3 butted
    tiles +17-18.5 / +13-14.1 / +10.3-11.2 %, 286 g, 52-56 mT peak at 20 A.
    - src/mech/hood_v20.py: v3 carrier (13 stepped pockets, tiles 27.0 x 26.2
    and 28.3 x 39.7 x 2.5 mm butted 0.2 mm),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
2026-10-23 Refresh data/results/check_v22.json to the 47-check run
    The committed file still held the 43 checks from before the QB lead-access
    and damping-resistor checks; the 43 shared checks and the masses are unchanged.
    Claude-Session: https://claude.ai/code/session_01JnzJXNccT7KpDKCaFv4J9E
2026-10-23 Hood v3: install STLs, results and figures; compute the no-gap end of the gain range
    - stl/head: LOTUS_HOOD_CARRIER_v3_butted and FERRITE_TILE_{INNER,OUTER}_v3_reference
    replace the v2 files; MANIFEST.csv hashes updated (48 rows, all match).
    - data/results: hood_v3_report.json, hood_v3_tile_cut_list.csv,
    hood_v3_tile_cut_sheet.dxf, hood_axi.json replace the v2 hood_report.json,
    hood_tile_cut_list.csv and hood_tile_cut_sheet.dxf.
    - docs/figures: HOOD_AXI.png, HOOD_V3_LAYOUT.png.
    - hood_axi.py: add the 0.0 mm joint row to the gap sweep, so the upper end of the
    stated v3 range is computed rather than read off the one-tile variant.
    v3 is now +16.9-18.5 / +12.9-14.2 / +10.2-11.2 % at 10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
2026-10-23 DESIGN_STATE: hood model matches Biot-Savart within 0.21 %, not 0.1 % (hood_axi.json: -0.21 % at 500 mm)
    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
2026-10-23 Enhancement review: state the turns-table assumptions, sources, owner handle decisions, PR numbers
    - Section 4: name how the turns table was made (sim_head1 pulse(), L x n^2, I / n)
    and the values held fixed (500 pF, 330 ohm chain, 45 mohm); copper loss is
    constant only with thicker litz in the same window (1.33 x with the same litz).
    - Section 5: source of the layer field ratios (reproduced: 0.693-0.884).
    - Section 3: joystick removed, index-finger trigger, battery rails under the
    grip/cuff joint (owner decision 2026-10-23); closes OPEN_ITEMS 16.
    - PR references (#3, #5, #6) and the hood v3 range from PR #6 (+12.9-14.2 %).
    Claud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
2026-10-23 Upper assembly v1 (WIP): S-stem generator, checks, PM2/HB2 boards, harness v3
    D044-A-style S-stem with index-finger trigger, MT60 battery dock under the bottom housing, armrest cup with 3 positions and a
    telescoping shaft with a twin cavity (septum + spacers) for the power and signal coiled cords. upper_check.py measures fits,
    interference, lengths, mass and torque on the meshes; power_dock_check.py checks the PM2 interlock, gate drive and soft start.
    HB2 drops the joystick; harness v3 replaces the ribbons with the two cords; wiring_audit, trigger_check and sch_export use them.
    Claude-Session: https://claude.ai/code/session_01JnzJXNccT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
2026-10-23 Upper assembly v1: design spec, DESIGN_STATE 8, ASSUMPTIONS 24-27, CORRECTIONS, OPEN_ITEMS 4/16/19-21
    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
2026-10-23 power_dock_check: create kit_v23 on a fresh setup
    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
2026-10-23 Upper assembly v1: results, schematics, placed PM2/HB2 boards, figure, curated STLs
    stl/upper: 10 printed parts + extended/collapsed assemblies (MANIFEST 60 rows, all hashes match).
    data/results: upper_v21_report, upper_check (57/57), power_dock_check (12/12), HARNESS_MASTER_v3; refreshed
    trigger_check, sch_check (9 boards), wiring_audit (50 conductors), system budget and stress table (P30B pack,
    AWG20 cord, PM2 fuse), head_crosscheck (was stale since PR #3: leak 10.3 mV, damping row, 2 warnings).
    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
2026-10-23 Head research review, configuration study C0-C3, system compatibility matrix and schematic
    config_study.py reuses sim_head1.depth_for, sbq_damp2.first_clean, hood_axi and the upper meshes (plus a light variant
    regenerated through UPPER_WALL / UPPER_DT) to compare C0 as built with C1 light and balanced, C2 early gate (12 turns per
    layer) and C3 endurance (P42A 21700 pack). system_compat.py lists every interface as OK / ACTION / DATA and draws the system
    schematic. New finding: PB1R bulk capacitors run at 84 % of their 35 V rating (CORRECTIONS, OPEN_ITEMS 24).
    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
2026-10-24 MRI-style target-field / stream-function TX winding study
    target_field_study.py reduces the six petal formers to axisymmetric equivalent loops (axis field within 0.1 % of the real
    paths, 51.5 uH vs 54), then finds the least-energy turn distribution for the as-built field (A), the same at equal energy (B)
    and for deep targets (C), within the same band and groove spacing, and runs each through the TX turn-off, first-gate and
    depth models. Result: the as-built Fermat petal winding is within about 2 % of the optimum; depth changes by 0 mm.
    CORRECTIONS: the enhancement review's +5-7 % for rim turns was per ampere, not at equal stored energy.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
